Jsalaz1989/Vapo/Arduinos/README.md

Proyecto de la asignatura de Microcontroladores y Lógica Programable del Máster. Es un vaporizador basado en Arduino que calienta un horno mediante control PID según indica el sensor de temperatura. 

Un Arduino Uno se comunica mediante I2C con un Arduino Uno Wifi para intercambiar datos y comandos. El Arduino Uno Wifi se comunica mediante MQTT con una Raspberry Pi, lo cual sirve de base para otro proyecto (asignatura de Computadores y Programación).
