Jsalaz1989/Vapo/Presentación.pptx

Flask

MQTT Bróker

Usuario + Presets

List:
Temp + Sesión

Temp + Sesión

MongoDB

Dict:
Temp + Sesión

Dict:
Temp

List:
Temp

Sub:
On, Temp

Pub:
On, Temp

MQTT Client

Arduino UNO Wifi

Control:
On, Temp

I²C

Reportar:
Temp

Pub:
Temp

Sub:
Temp

MQTT Client

Temp + Sesión

Protobuf

GUI

Arduino UNO

Notes: GENERAL

## Slide 2

https://youtu.be/7sbwrf8wxNI

Flask

MongoDB

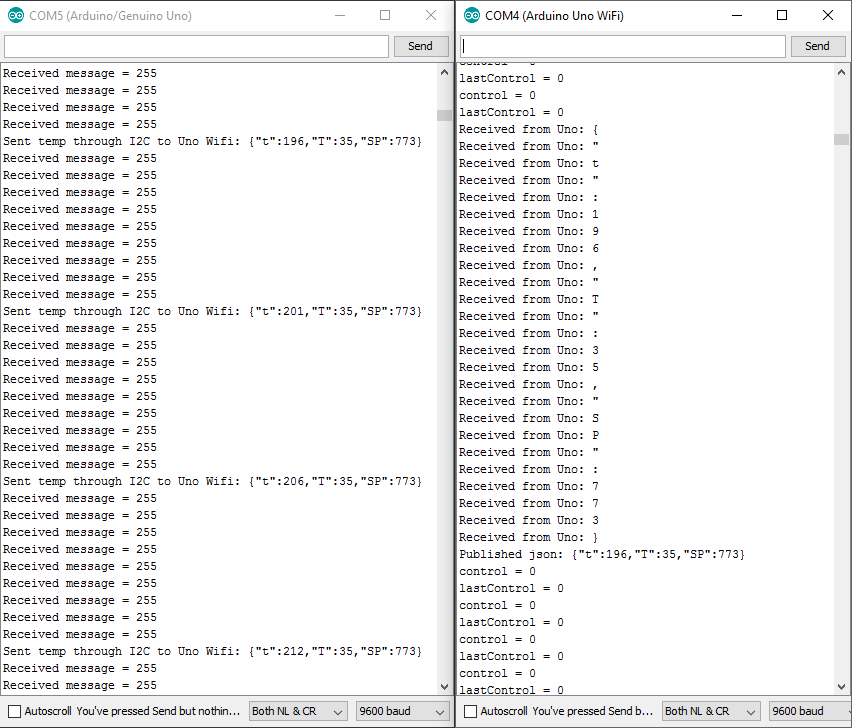
[picture p1: figure]

MQTT Bróker

pubControl(999)

vape/control
pubControl(0)

subTemp()

vape/temp
hilo

List:
Temp + Sesión

Temp + Sesión

Dict:
Temp + Sesión

MQTT Client

Dict:
Temp

List:
Temp

Sub:
On, Temp

Pub:
On, Temp

MQTT Client

Arduino UNO Wifi

Control:
On, Temp

I²C

Reportar:
Temp

Pub:
Temp

Sub:
Temp

Temp + Sesión

Protobuf

Usuario + Presets

GUI

Arduino UNO

Notes: MQTT

## Slide 3

Volver a elección de usuario

Elegir usuario

Historial (mongoDB)

Flask

MongoDB

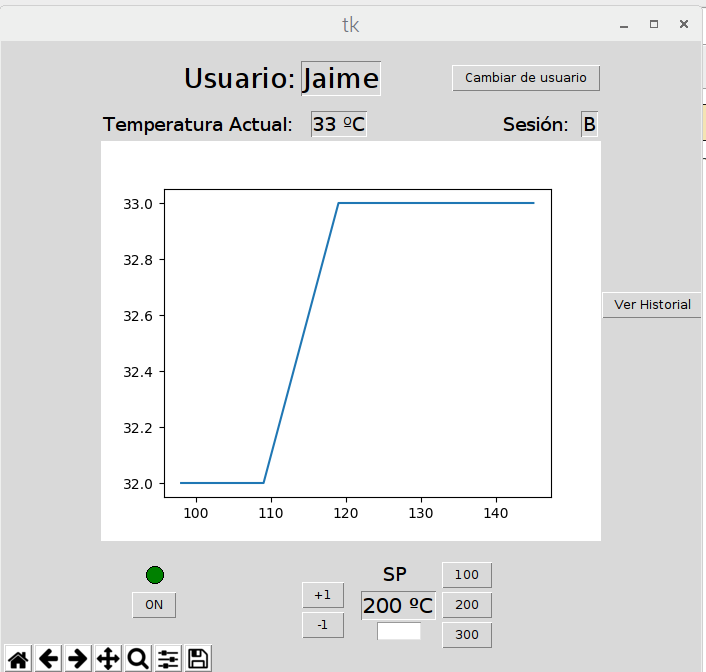
[picture p2: figure]

Borrar mongo al arrancar GUI
y al apagar Arduino

Gráfico (borrar y sobrescribir)

MQTT Bróker

Usuario + Presets

List:
Temp + Sesión

Funciones de actualización

self.after()

subTemp()

pubControl(999)

Temp + Sesión

Dict:
Temp + Sesión

hilos

Dict:
Temp

List:
Temp

Sub:
On, Temp

Pub:
On, Temp

MQTT Client

Arduino UNO Wifi

Control:
On, Temp

I²C

Reportar:
Temp

readPerfil(usuario)

readmessage.py con if

https://youtu.be/6FR_B6w8pXI

Pub:
Temp

Sub:
Temp

MQTT Client

Temp + Sesión

Arduino UNO

Protobuf

GUI

Notes: GUI

## Slide 4

https://youtu.be/6FR_B6w8pXI
(el mismo de la diapositiva anterior)

deleteAllMongo()

Flask

getMongo()

subTemp()

postMongo()

MQTT Bróker

animate()

List:
Temp + Sesión

Temp + Sesión

MongoDB

Dict:
Temp + Sesión

Dict:
Temp

List:
Temp

Sub:
On, Temp

Pub:
On, Temp

MQTT Client

Arduino UNO Wifi

Control:
On, Temp

I²C

Reportar:
Temp

Pub:
Temp

Sub:
Temp

while

GUI

MQTT Client

Temp + Sesión

Arduino UNO

Protobuf

Usuario + Presets

Notes: GRÁFICA (MONGO)

## Slide 5

Flask

https://youtu.be/MhaEAIw5f68

deleteCarriotsSession(sesion)

MQTT Bróker

List:
Temp + Sesión

getCarriots()

subTemp()

postCarriots()

MQTT Client

Temp + Sesión

if “A”
elif “B”

Dict:
Temp + Sesión

en cambio de sesión
if

MongoDB

animate()

Dict:
Temp

List:
Temp

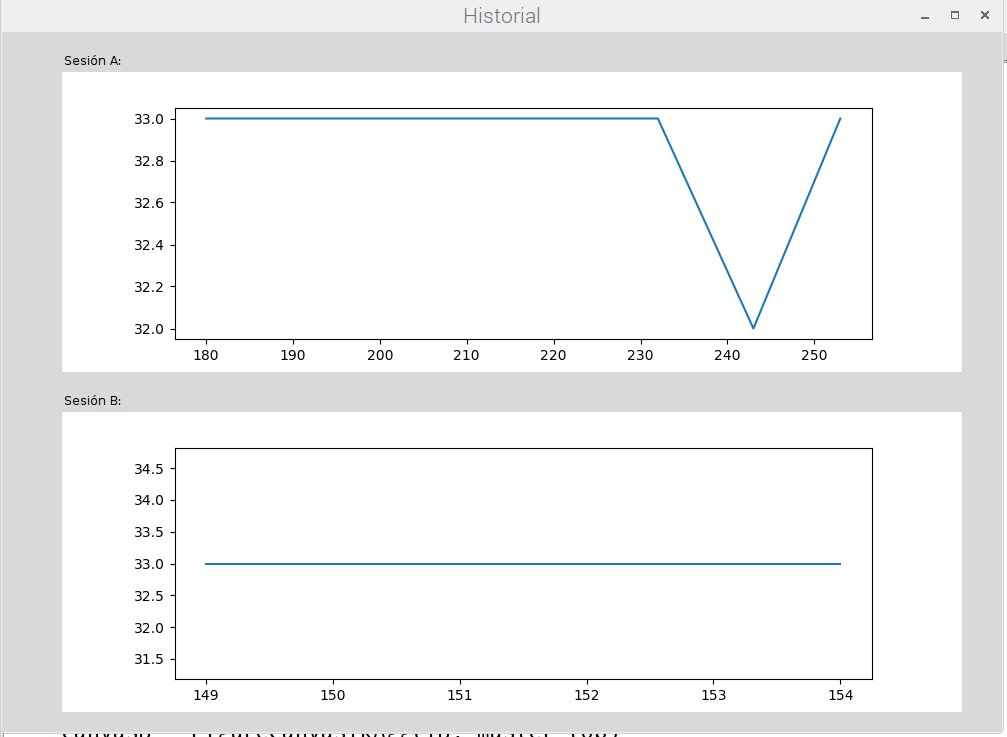
[picture p3: figure]

Sub:
On, Temp

Pub:
On, Temp

MQTT Client

Arduino UNO Wifi

Control:
On, Temp

I²C

Reportar:
Temp

Pub:
Temp

Sub:
Temp

GUI

Temp + Sesión

Arduino UNO

Protobuf

Usuario + Presets

Notes: HISTORIAL (CARRIOTS)

## Slide 6

Flask

@app.route(“/usuario/<sesion>”)
if sesion

getMongo()

MQTT Bróker

List:
Temp + Sesión

Temp + Sesión

MongoDB

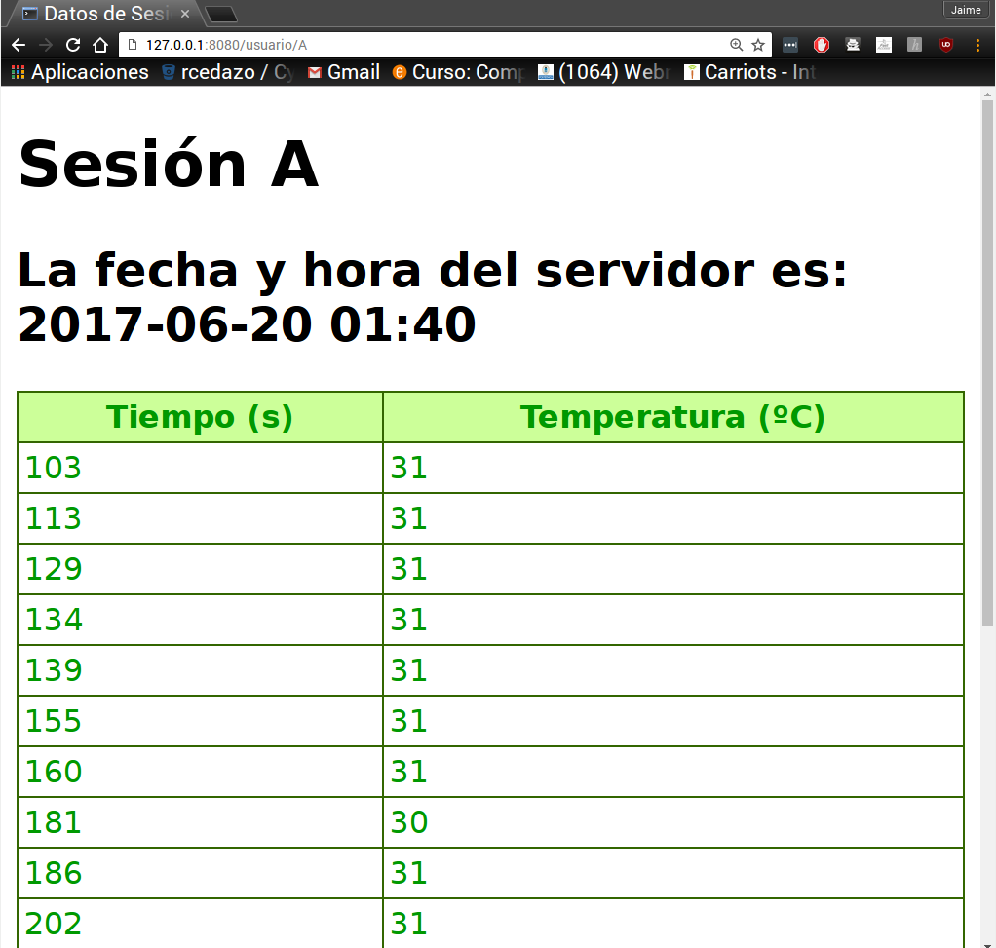
[picture p4: figure]

Dict:
Temp + Sesión

List:
Temp

Dict:
Temp

https://youtu.be/TPxzVgZ_yS8

Sub:
On, Temp

Pub:
On, Temp

MQTT Client

Arduino UNO Wifi

Control:
On, Temp

I²C

Reportar:
Temp

Pub:
Temp

Sub:
Temp

WEB

MQTT Client

Temp + Sesión

Arduino UNO

Protobuf

Usuario + Presets

Notes: HISTORIAL (CARRIOTS)

## Referencias

- https://circuits.io/ (https://www.adafruit.com/includes/templates/adafruit2013/images/little_pi.png)
- https://www.adafruit.com/includes/templates/adafruit2013/images/little_pi.png
- https://cdn.pixabay.com/photo/2016/03/30/13/24/wifi-1290667_960_720.png
- http://www.hotelcentral-basilica.hu/inc/filemanager/files/download.png
- https://www.carriots.com/
