Jsalaz1989/Vapo/Memoria.pdf

# Vaporizador

# Basado en Arduino

## Máster en Ingeniería Electromecánica

### Microcontroladores y Lógica Programable

### Jaime Salazar Lahera junio 2017

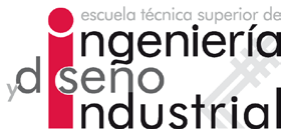
[picture p5: figure]

Microcontroladores y Lógica Programable, Sistemas Mecatrónica Máster en Ingeniería Electromecánica

## Vaporizador Basado en Arduino

### 0 General

Se trata de un vaporizador de muestras vegetales o aceites esenciales que volatiliza el material en un horno pequeño. Consiste principalmente de un Arduino Uno R3, un Arduino Uno Wifi, un horno, y un sensor de temperatura (Figura 0.0, Anexo?).
El Arduino Uno Wifi recibe las señales de los

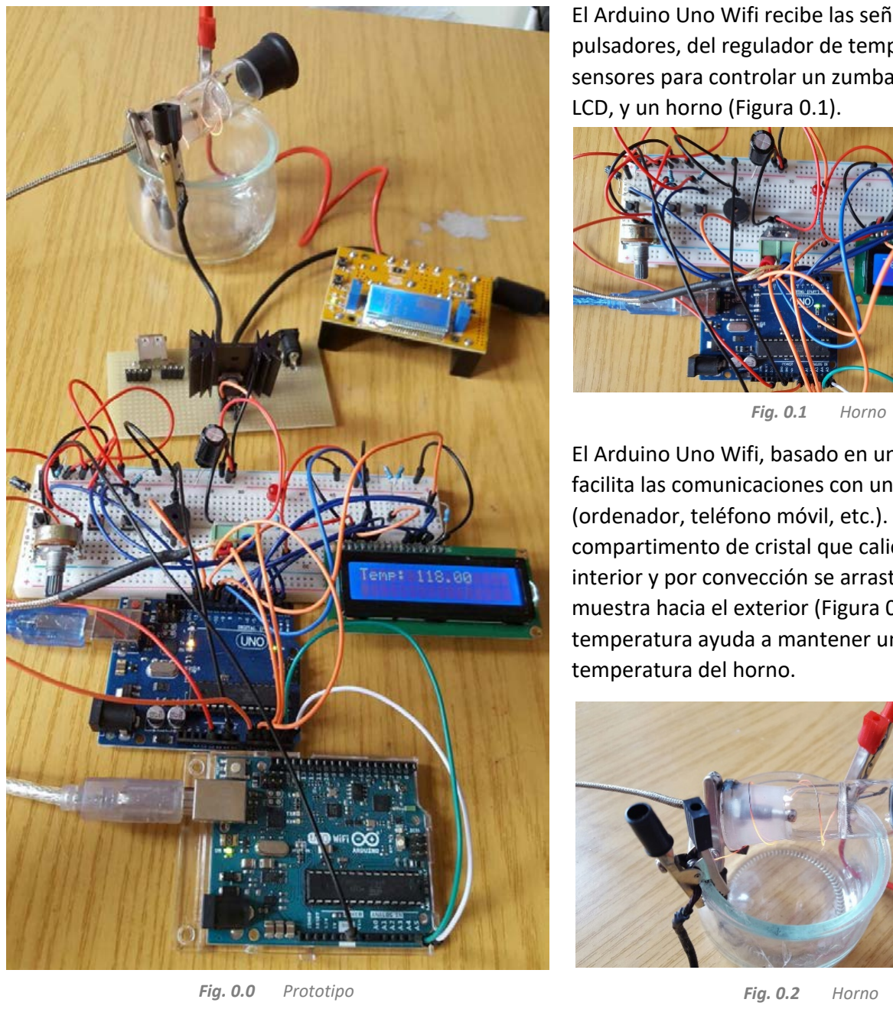
[picture p6: figure]
Fig. 0.0 Prototipo; Fig. 0.2; Horno; Fig. 0.1

pulsadores, del regulador de temperatura, y de los sensores para controlar un zumbador, una pantalla LCD, y un horno (Figura 0.1).

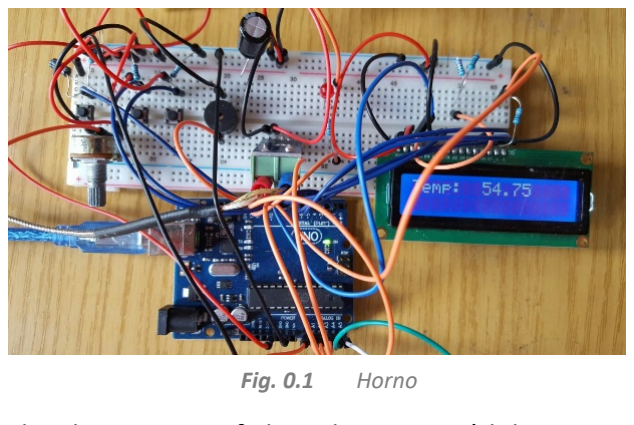
[picture p7: figure]

El Arduino Uno Wifi, basado en un módulo ESP8266, facilita las comunicaciones con una interfaz externa (ordenador, teléfono móvil, etc.). El horno es un compartimento de cristal que calienta el aire en su interior y por convección se arrastra los vapores de la muestra hacia el exterior (Figura 0.1). Un sensor de temperatura ayuda a mantener un seguimiento de la temperatura del horno.

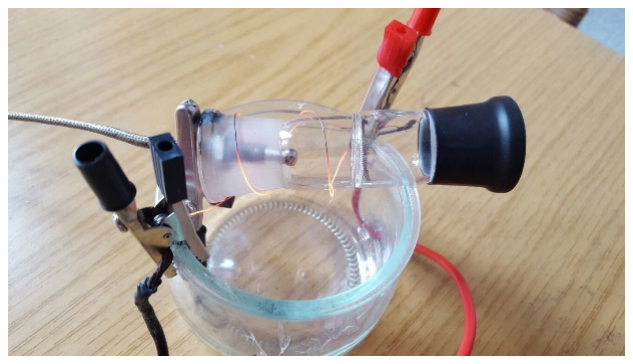
[picture p8: figure]

La Figura 0.3 es un esquema final desarrollado en la página www.circuits.io. Su selección limitada de componentes obliga a representar, por ejemplo, al sensor de temperatura de 5 patillas con sólo 3 o el transistor de forma TO-220 como un pequeño transistor PN2222. No obstante, se presenta como una idea básica del circuito en cuestión.

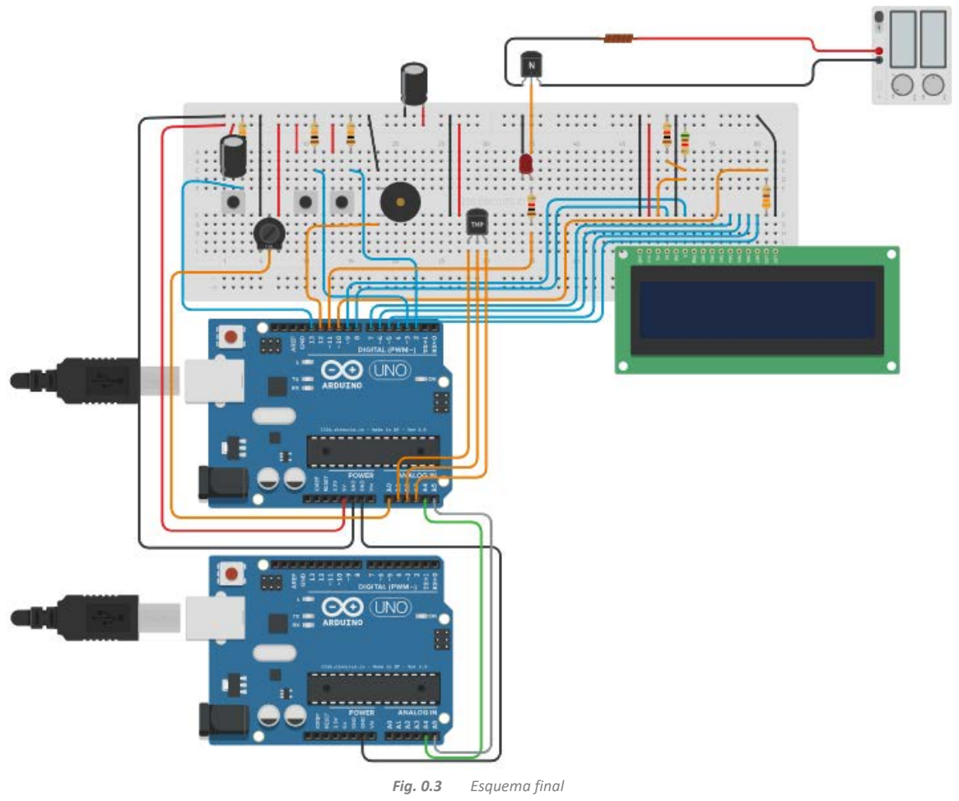
[picture p9: figure]
Fig. 0.3; Esquema final

Las etapas principales del proyecto son las siguientes:

Cada etapa resume primero el circuito y su código final (Descripción), seguido por apuntes complementarios sobre su desarrollo (Proceso), y las fuentes utilizadas (Referencias).

### 1 Pulsador ON

Descripción
El pulsador ON enciende o apaga el vaporizador dependiendo de si el sistema actualmente está apagado o encendido, respectivamente. Con la función attachPinChangeInterrupt() de la librería PinChangeInt.h¹

, (http://playground.arduino.cc/Main/PinChangeInterrupt)
se prepara una interrupción en la patilla digital 11, sin tener que limitarse a las patillas 2 y 3 que se utilizan por defecto para interrupciones externas. De esta forma, se reservan estas dos patillas para los pulsadores de temperatura. La interrupción se lanza con un flanco positivo del pulsador ON mediante su parámetro ´RISING´ y llama a la función onOff(). El rebote se ha eliminado con un condensador electrolítico de 1 μF.
Dentro de onOff() se encuentran on() y off(),
de formato y propósito prácticamente opuestos.
Respectivamente, éstas activan o desactivan al
temporizador de seguridad, emiten un tono alto y corto o bajo y largo mediante tone()³

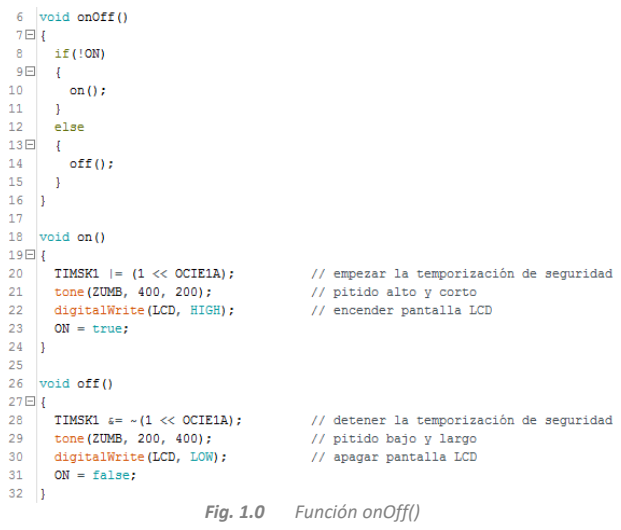
[picture p10: figure]
Fig. 1.0 Función onOff()

, (https://www.arduino.cc/en/reference/tone) encienden
o apagan la pantalla LCD, y establecen el valor de la marca booleana ON (Figura 1.0).
Dentro del loop(), la marca ON habilita al horno, la pantalla LCD, y el envío de datos de temperatura y, además, mediante con millis() se “ralentiza” la frecuencia de ejecución de estas funciones para reducir el gasto energético (Figura 1.1). Se permite recibir el control remoto aún apagado por si llega un commando de encendido.

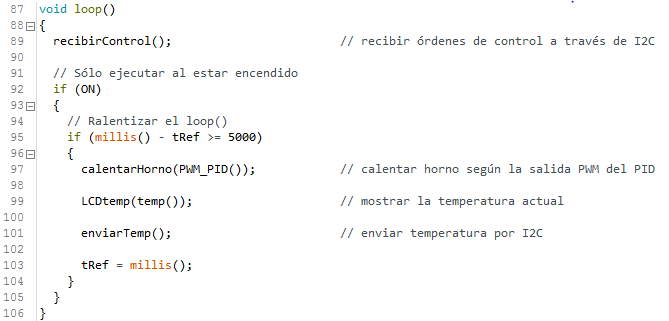
[picture p11: figure]

Fig. 1.1 Función loop()

Como medida de seguridad, nada más encenderse el vaporizador se inicia una temporización de 30 minutos con el temporizador 1, tras los cuales se apaga el sistema. En el setup() la función inicializarISR() inicializa a esta ISR (Figura 1.2) deshabilitando primero a las interrupciones globales y reseteando los registros TCCR1A y TCCR1B. A continuación, se establece una comparación con un valor de 1 segundo, el modo CTC del temporizador, y un pre-escalado de 1024. Finalmente se habilita esta interrupción, así como las interrupciones globales⁴ (http://www.engblaze.com/microcontroller-tutorial-avr-and-arduino-timer-interrupts/) (Figura 1.1). En particular, OCR1A se compara constantemente con TCNT1, que almacena la cuenta actual del temporizador, ambos siendo registros de 16 bits⁵
. (http://www.atmel.com/Images/Atmel-42735-8-bit-AVR-Microcontroller-ATmega328-328P_Datasheet.pdf) El valor de OCR1A = 15624 surge de la siguiente fórmula, donde tt = 1 es el tiempo deseado de 1 segundo y rr = 6,4 ∙ 10−5 segundos es la resolución del temporizador⁴ : (http://www.engblaze.com/microcontroller-tutorial-avr-and-arduino-timer-interrupts/)

# tt = rr ∙ (OOOOOO1AA + 1) ⇒ OOOOOO1AA = tt

# rr − 1 = 1 ssssss 6,4 ∙ 10−5 ssssss − 1 = 15624

Con un TCCR1A completamente reseteado y un TCCR1B cuyo bit WGM12 se pone a 1, se establece la combinación WGM1[3:0] = 0100, codificando el modo 4 de la Tabla 20-6 (modo CTC) con OCR1A como TOP y su actualización inmediata⁵ . (http://www.atmel.com/Images/Atmel-42735-8-bit-AVR-Microcontroller-ATmega328-328P_Datasheet.pdf)
Con un TCCR1B generalmente

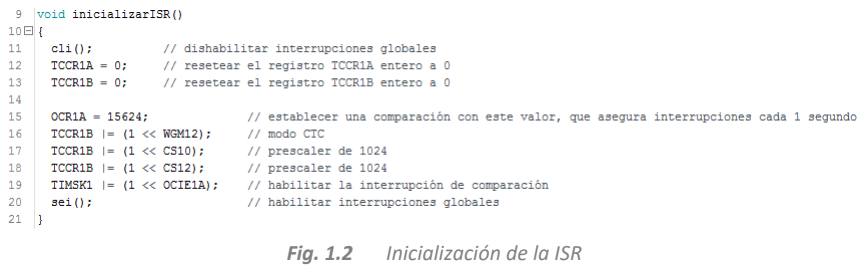
[picture p12: figure]
Fig. 1.2 Inicialización de la ISR

reseteado y una activación de sus bits CS10 y CS12, los tres primeros bits del registro TCCR1B son de la forma de 101, codificando para un pre-escalado de 1024. Finalmente, se habilita esta interrupción de comparación en la máscara TIMSK1 al poner su bit OCIE1A a 1 y se habilitan las interrupciones generales para finalizar la inicialización de la interrupción (Figura 1.2).
Esta inicialización lanza la ISR cada segundo, añadiendo 1 al contador de segundos. Cada 1800 interrupciones (cada 30 minutos) se reinicia la cuenta y se llama a off() para apagar el vaporizador (Figura 1.3), si el usuario se deja el vaporizador encendido, a la media hora se apaga el dispositivo y se evita también el gasto energético.

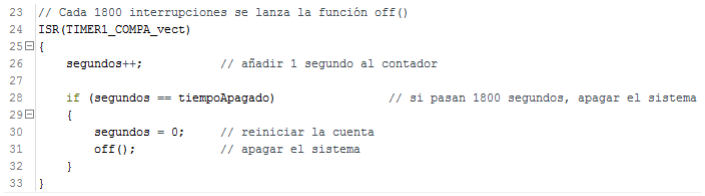
[picture p13: figure]

Fig. 1.3 ISR

Proceso
Para reducir el uso de materiales, es preferible eliminar el rebote por medio del software pero las funciones millis() o delay() no son muy compatibles con las interrupciones⁶

. (https://arduino.stackexchange.com/questions/22212/using-millis-and-micros-inside-an-interrupt-routine)
También era preferible encontrar un valor del registro OCR1A que produjese una interrupción a los 30 minutos, pero el límite de los temporizadores de unos pocos segundos⁷ (https://forum.arduino.cc/index.php?topic=419606.0) ha resultado en el método de interrupciones de un 1 segundo descrito anteriormente. Haciendo pruebas de 10 segundos se observa en la Figura 1.4 que la primera interrupción se lanza a los 2 milisegundos, probablemente el tiempo que transcurre entre el encendido del Arduino, su recorrido por setup(), y los primeros ciclos del loop().

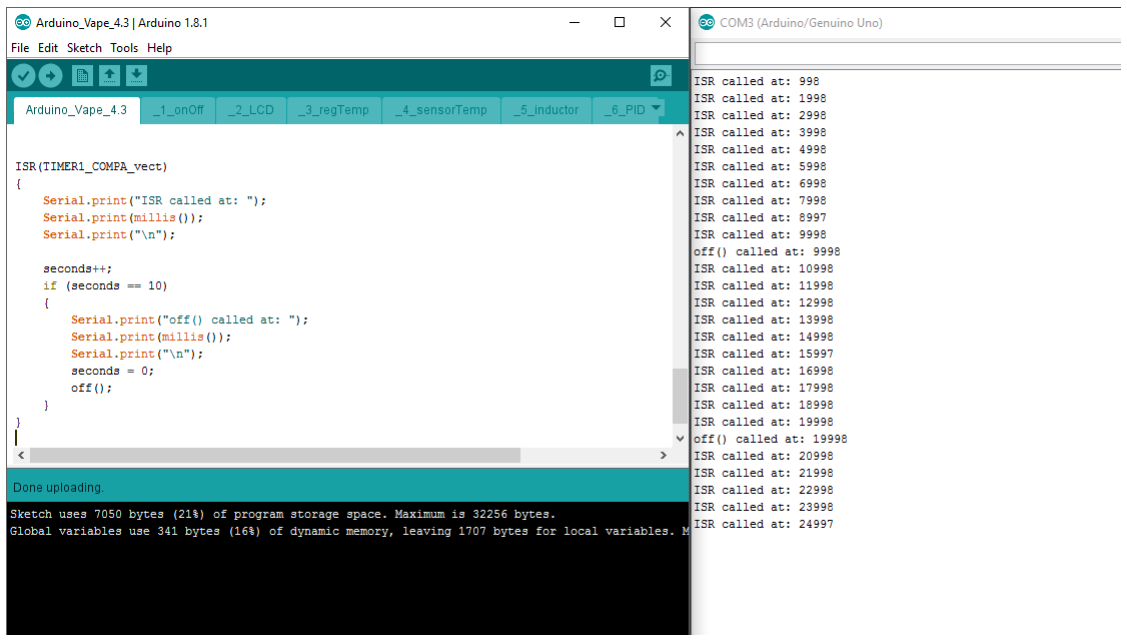
[picture p14: figure]

Ya que el Arduino en principio sigue contando y ejecutando las interrupciones pese a la llamada a off(), conviene desactivar la máscara TIMSK1 en dicha función para reducir cualquier gasto energético asociado a estas interrupciones innecesarias, aunque se trate de un gasto mínimo.

Referencias
1. http://playground.arduino.cc/Main/PinChangeInterrupt
2. https://brainy-bits.com/blogs/tutorials/make-any-arduino-pin-an-interrupt-pin
3. https://www.arduino.cc/en/reference/tone
4. http://www.engblaze.com/microcontroller-tutorial-avr-and-arduino-timer-interrupts/
5. http://www.atmel.com/Images/Atmel-42735-8-bit-AVR-Microcontroller-ATmega328-328P_Datasheet.pdf
6. https://arduino.stackexchange.com/questions/22212/using-millis-and-micros-inside-an-interrupt-routine
7. https://forum.arduino.cc/index.php?topic=419606.0

Fig. 1.4 Prueba del ISR

### 2 Pantalla LCD

Descripción
La pantalla LCD (16x2) se enciende con el pulsador ON ya que éste manda 5 V al ánodo de la pantalla (Sección 1). Inmediatamente en el setup() la función LCDinit() muestra una pantalla de bienvenida (Figura 2.1). En el loop() cada 5 segundos se llama a la función LCDtemp() (Figura 1.1) para que muestre en pantalla el resultado de la función temp() proveniente del sensor de temperatura (Sección 4). De esta forma, se refresca la pantalla al mismo ritmo al que se actualiza la temperatura actual. Por último, la pantalla también muestra el valor de temperatura deseado cada vez que se modifica mediante el regulador de temperatura (Sección 3).

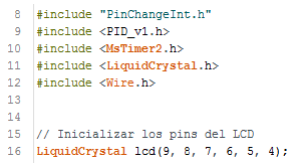
[picture p15: figure]
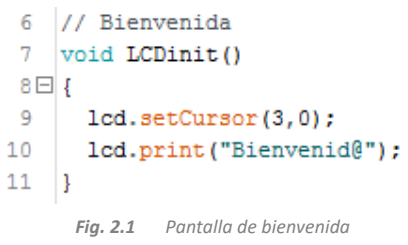
[picture p16: figure]
Fig. 2.1 Pantalla de bienvenida

Con la librería de LiquidCrystal.h se inicializa la pantalla LCD con su 6 patillas (Figura 2.2). En el fichero “_2_LCD.ino” se crea la función LCDtemp(), que recibe el valor de la temperatura actual según el sensor de temperatura y la muestra en pantalla. Varía la posición del valor según su número de dígitos para alinear la coma decimal (Figura 2.3).

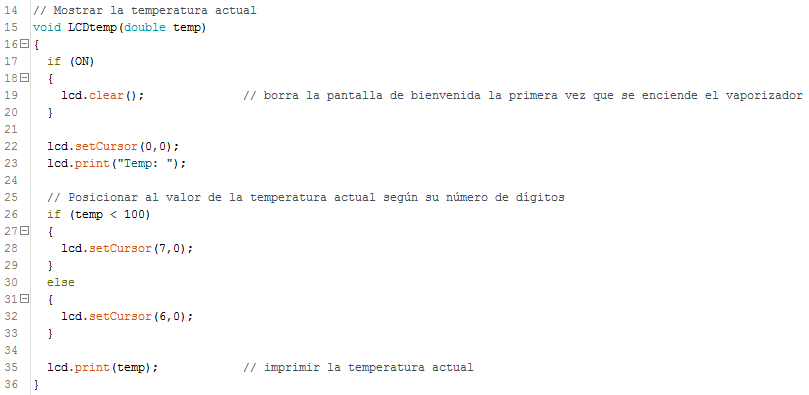
[picture p17: figure]

Fig. 2.3 Temperatura actual en pantalla

Fig. 2.2 Pantalla de bienvenida

Proceso
La luz de fondo de la pantalla se ha establecido con un divisor de tensión para simplificar los materiales, aunque un potenciómetro produce un mejor contraste. Los valores de las resistencias del divisor se basaron en las medidas del divisor formado por el potenciómetro. Al estar las demás patillas ocupadas con los demás componentes, no se ha podido utilizar una patilla PWM para controlar la luz de fondo, aunque sería preferible para reducir aún más el uso de materiales.
El parpadeo de la pantalla de temperatura actual se solucionó con la ralentización del loop(), ya que la función lcd.print() estaba intentando imprimir y re-imprimir a un ritmo excesivo¹

. (http://forum.arduino.cc/index.php?topic=138249.0) Los problemas a la hora de mostrar la consigna se detallan en la siguiente sección ya que están muy ligados a esa interrupción.
Referencias
1. http://forum.arduino.cc/index.php?topic=138249.0

### 3 Regulador de Temperatura

Descripción
Para establecer la temperatura deseada se puede utilizar pulsadores o un potenciómetro. Con los pulsadores se incrementa o decrementa la consigna actual al lanzar las interrupciones externas 0 y 1, asociadas a las patillas 2 y 3, que llaman a las funciones incrementSP() y decrementSP(), respectivamente. Éstas funciones casi idénticas primero deshabilitan al resto de funciones del
sistema mediante el marcador ON. De esta forma, mientras se
esté modificando la consigna ni el horno ni su controlador PID

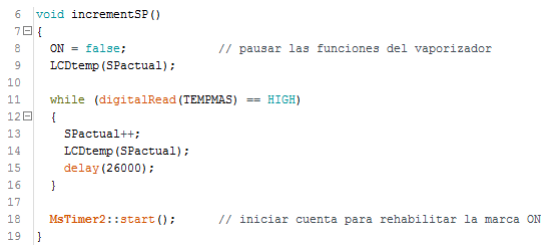
[picture p18: figure]

están activos. La función inmediatamente muestra el valor de la consigna actual y, mientras el usuario siga presionando el pulsador en cuestión, aumenta o disminuye el valor de SPactual, mientras se actualiza el valor de la consigna en pantalla con LCDtemp(SPactual) (Figura 3.0). El bucle while() junto con delay() resulta en un barrido de temperaturas mientras se mantenga presionado al pulsador. El uso de estas funciones dentro de una interrupción se detalla en la siguiente sección (Proceso). Una vez se deja de pulsar el botón empieza una cuenta en el temporizador 2 gracias a la librería de MsTimer2.h¹

. (https://playground.arduino.cc/Main/MsTimer2) Ésta establece una resolución de 1 milisegundo en T2 y permite establecer en el setup() una interrupción cada 800 milisegundos que llame a la función habilitar(). Ahora se puede iniciar la cuenta en otras zonas del código con MsTimer2::start(), que aparece en las funciones del fichero “_3_SP.ino”.
Una vez transcurridos los 800 milisegundos, la función habilitar() (Figura 3.1) re-establece al marcador ON, por lo que se podrá resumir las demás funciones del vaporizador. De esta forma, el horno y su PID vuelven a arrancar cuando ya se ha decidido la nueva consigna. La función emite un zumbido para confirmar el cambio de consigna, borra la pantalla LCD de la consigna y acelera la

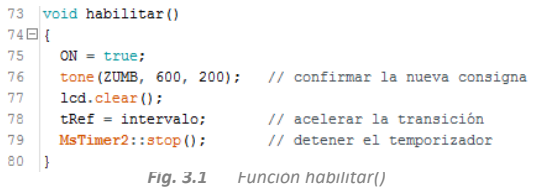
[picture p19: figure]
Fig. 3.1 Función habilitar()

transición de vuelta a pantalla de la temperatura actual. Por último, detiene la temporización.

Fig. 3.0 Incremento de temperatura por pulsador

Por otro lado, se puede variar la consigna con un potenciómetro de 10K, cuyo pin A0 genera una interrupción preparada en el setup() con a la función attachPinChangeInterrupt()que detecta un cambio en el pin del regulador para llamar a la función regTemp() (Figura 3.2). Esta función interpola la lectura analógica del potenciómetro entre 180 y 200 °C con la función map(). En seguida compara lecturas previas y actuales y, con la ayuda de un contador que actúa como temporizador, detecta cuando ha pasado un determinado “tiempo” desde la última vez que se movió el regulador. El uso de while() también se detalla en el siguiente sub-apartado.

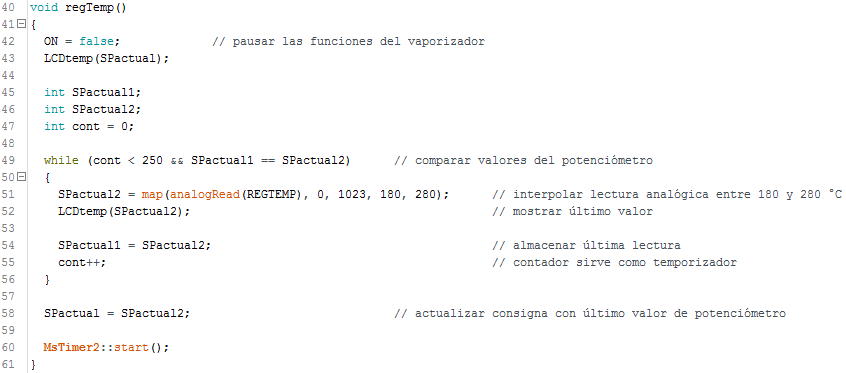
[picture p20: figure]
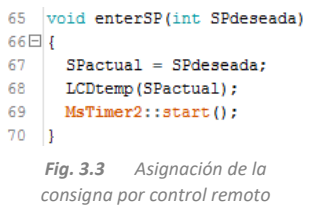
[picture p21: figure]
Fig. 3.3 Asignación de la consigna por control remoto

La última forma de modificar la consigna es mediante la interfaz remota a través de la comunicación I²
C (Sección 7). Para ello se recibe el valor de la consigna como parámetro de la función enterSP(), que actualiza a la variable global SPactual (Figura 3.3).

Proceso
Las interrupciones de los pulsadores aumentan o disminuyen la consigna de uno en uno con cada pulsación. El uso de while() dentro de la interrupción, permite que además, tras un flanco inicial, uno pulso constante produzca un rápido ascenso o descenso de la consigna hasta que se deje de presionar el pulsador. Sin un delay(), este bucle produce ascenso o descenso demasiado rápido y un valor de 2600 como parámetro consigue un barrido de temperaturas a un ritmo satisfactorio. No se ha podido conseguir el mismo efecto con las funciones millis() ni micros(), las cuales no son muy útiles dentro de una interrupción²

. (https://arduino.stackexchange.com/questions/22212/using-millis-and-micros-inside-an-interrupt-routine)
El uso de while() dentro de la interrupción del potenciómetro permite la comparación continua de valores durante suficiente tiempo. De esta forma, el procesador no está constantemente saltando entre el loop() y la interrupción, lo cual en las pruebas iniciales resultaba en saltos erráticos en la consigna al mover el regulador. La Figura 3.4 muestra una prueba inicial de las lecturas analógicas.

Fig. 3.2 Incremento de temperatura por potenciómetro

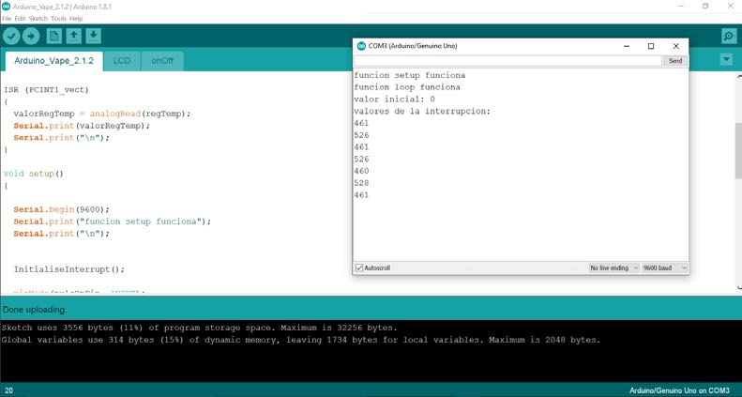
[picture p22: figure]

Los valores de interpolación del potenciómetro son valores de temperatura típicos para vaporizadores herbales y el horno está dimensionado para producir este rango aproximadamente (Sección 5).
En realidad, se preferiría utilizar la interrupción externa 0 para el pulsador ON ya que éste debería tener la máxima prioridad siempre. Sin embargo, por no cruzar cables ni separar a las patillas de los pulsadores TempMás y TempMenos se decidió dejarlo así. No es probable que la jerarquía de interrupciones descrita en la Figura 3.5 tenga mucho efecto en este proyecto ya que un usuario no suele pulsar más de una entrada en un momento dado.

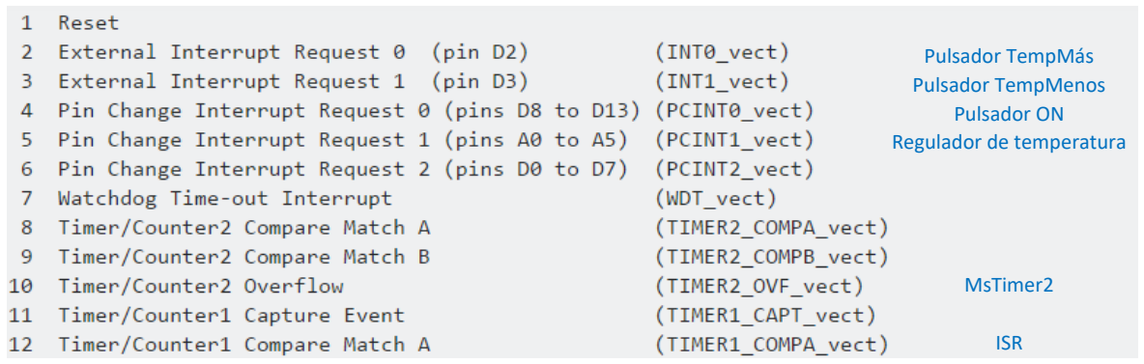
[picture p23: figure]
Pulsador TempMás Pulsador TempMenos Pulsador ON Regulador de temperatura; MsTimer2; ISR

Referencias
1. https://playground.arduino.cc/Main/MsTimer2
2. https://arduino.stackexchange.com/questions/22212/using-millis-and-micros-inside-an-interrupt-routine
3. https://stackoverflow.com/questions/5111393/do-interrupts-interrupt-other-interrupts-on-arduino

Fig. 3.4 Saltos erráticos entre lecturas analógicas

Fig. 3.5 Prioridad de las interrupciones³ (https://stackoverflow.com/questions/5111393/do-interrupts-interrupt-other-interrupts-on-arduino)

### 4 Sensor de Temperatura

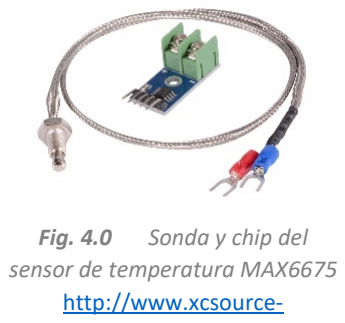
[picture p24: figure]
Fig. 4.0 Sonda y chip del sensor de temperatura MAX6675 http://www.xcsource-

Descripción del Hardware
Un sensor MAX6675 detecta la temperatura del horno cada 5 segundos y, junto con el inductor (Sección 5), permite cerrar el bucle de control PID (Sección 6). Su sonda es capaz de detectar la fuente de calor (entre 0°C y 1023.75°C) con su unión caliente mientras mantiene alejada la unión fría (entre -20°C y 85°C) ¹
, (http://henrysbench.capnfatz.com/wp-content/uploads/2015/05/MAX6675-Datasheet.pdf) es decir, el chip MAX6675 (Figura 4.0). Este chip está conectado a las patillas analógicas del Arduino, aunque normalmente se conectan a las digitales (Figura 4.1). Los termopares de tipo K, como este sensor, trabajan bien en atmósferas oxidantes²
, (https://en.wikipedia.org/wiki/Thermocouple#Type_K) una característica muy conveniente para un sensor de flujos de aire caliente.

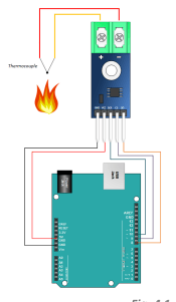
[picture p25: figure]
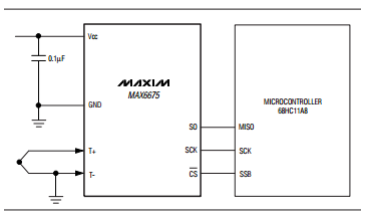
[picture p26: figure]

Al tratarse de un termopar de tipo K, tiene una entrada T- de alumel (niquel-aluminio) y T+ de cromel (niquel-cromo). La Figura 4.2 también muestras su patilla de alimentación (Vcc), de tierra (GND), una salida Serial Data Ouput (SO), y las entradas Serial Clock Input (SCK) y Chip Select (CS)¹
. (http://henrysbench.capnfatz.com/wp-content/uploads/2015/05/MAX6675-Datasheet.pdf)

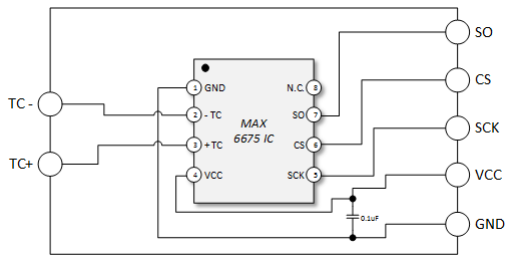
[picture p27: figure]
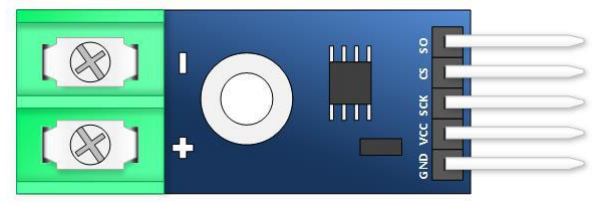
[picture p28: figure]

Fig. 4.2 Detalle de las patillas del sensor³ (http://henrysbench.capnfatz.com/henrys-bench/arduino-temperature-measurements/max6675-temp-module-arduino-manual-and-tutorial/)

Fig. 4.1 Imagen⁴

, (http://henrysbench.capnfatz.com/henrys-bench/arduino-temperature-measurements/max6675-temp-module-arduino-manual-and-tutorial/) cableado⁴

, (http://henrysbench.capnfatz.com/henrys-bench/arduino-temperature-measurements/max6675-temp-module-arduino-manual-and-tutorial/) y diagrama¹ (http://henrysbench.capnfatz.com/wp-content/uploads/2015/05/MAX6675-Datasheet.pdf) del sensor de temperatura Nota: En este proyecto, se usan patillas analógicas en lugar de digitales

La Figura 4.14 contiene al circuito entero del chip MAX6675, el cual se alimenta mediante la fuente VCC, cuyo ruido se recomienda minimizar mediante un condensador cerámico de 0.1 µF¹ (http://henrysbench.capnfatz.com/wp-content/uploads/2015/05/MAX6675-Datasheet.pdf) (Figura 4.4). Éste se coloca cerca del pin de alimentación (Figura 4.4), como es típico de los condensadores de paso, también conocidos como de derivación (Figura 4.4)
5

. (http://www.electronica2000.com/temas/capacitores-de-paso.htm)

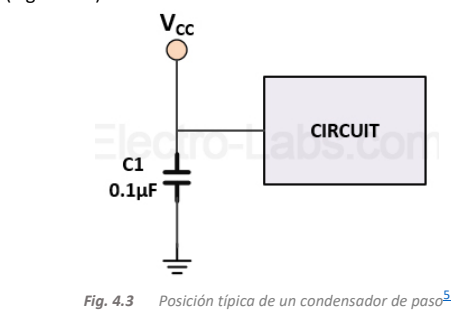
[picture p29: figure]
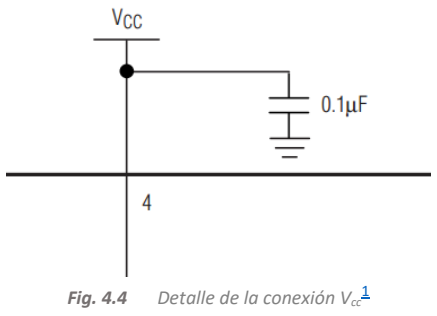
[picture p30: figure]
Fig. 4.4 Detalle de la conexión Vcc1

Este tipo de condensador limpia la señal de entrada, una tensión c.c. con pequeñas oscilaciones c.a., para producir una tensión c.c. pura (Figura 4.5 y 4.6).

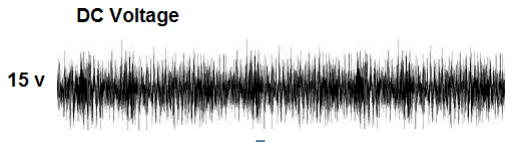
[picture p31: figure]
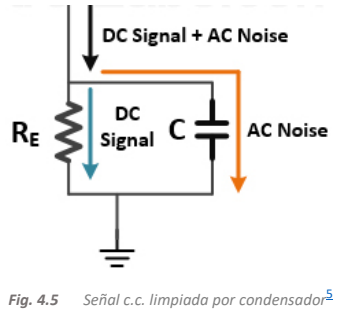
[picture p32: figure]

Esta tensión alimenta al amplificador A1, descrito en el manual como un amplificador de bajo ruido (LNA)¹

, (http://henrysbench.capnfatz.com/wp-content/uploads/2015/05/MAX6675-Datasheet.pdf) que
recibe las señales del termopar T+ y T- (Figura 4.7). Estas entradas pasan primero por los conmutadores S1, S2, y S3, que no se detallan en la documentación oficial, pero podrían tratarse de interruptores chopper que trocean la señal continua para producir una señal alterna, que es más fácil de manejar dentro de un amplificador⁷
. (https://en.wikipedia.org/wiki/Chopper_(electronics)#Chopper_amplifiers) Aunque el
diagrama representa a este amplificador como un amplificador operacional (op-amp) estándar, casi siempre se trata de 3 op-amps (Figura 4.8) que forman un amplificador de instrumentación⁷
. (https://en.wikipedia.org/wiki/Instrumentation_amplifier)

Fig. 4.6 Limpieza de una señal c.c.⁶ (http://www.learningaboutelectronics.com/Articles/What-is-a-bypass-capacitor.html) Fig. 4.5 Señal c.c. limpiada por condensador⁵ (http://www.electronica2000.com/temas/capacitores-de-paso.htm)

Fig. 4.3 Posición típica de un condensador de paso⁵ (http://www.electronica2000.com/temas/capacitores-de-paso.htm)

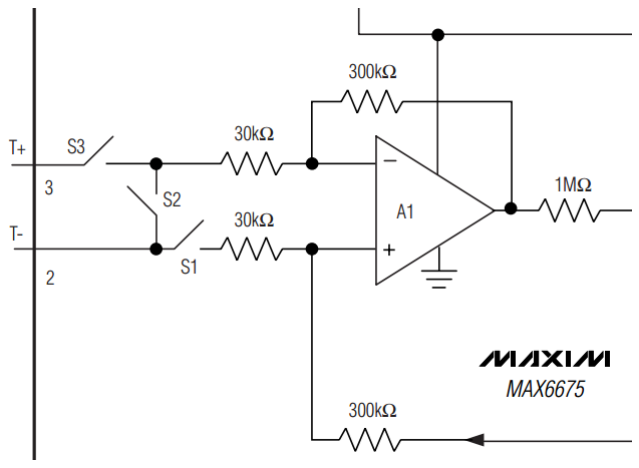
[picture p33: figure]

Fig. 4.7 Detalle del amplificador A1¹ (http://henrysbench.capnfatz.com/wp-content/uploads/2015/05/MAX6675-Datasheet.pdf)

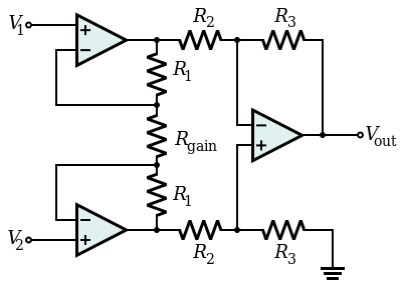
[picture p34: figure]

Fig. 4.8 Amplificador de instrumentación⁸ (https://en.wikipedia.org/wiki/Instrumentation_amplifier)

Los dos primeros op-amps funcionan como buffers para cada entrada (+,-) y proporcionan una tensión entre las dos entradas (justo antes de las resistencias 2 = 30 kkkk) de: VViiiiiiiiiiiiiiiiiiii = (VV2 − VV1) 1 + 2RR1

# RRgggggggg9

. (https://es.wikipedia.org/wiki/Amplificador_de_instrumentaci%C3%B3n) Como no se
conocen los valores de las resistencias 1 ni gg , no se puede calcular la ganancia de esta etapa, pero se sabe que los amplificadores de instrumentación suelen ser amplificadores diferenciales con un alto factor rechazo al modo común y una pequeña ganancia de modo común
RR2
RR3

# = 30 kkkk

300 kkkk = 0.1. Es decir, la primera etapa del

amplificador A1 es muy capaz de rechazar el ruido ambiental común a las dos entradas sin amplificarlo mucho¹⁰. (https://en.wikipedia.org/wiki/Common-mode_rejection_ratio) En la segunda etapa, la tensión intermedia caerá por igual al cruzar las resistencias 2, por lo que llegará la misma diferencia a las entradas del tercer op-amp. Éste producirá una tensión de salida VVoo = (VV2 − VV1) 1 + 2RR1

# RRgggggggg RR3

RR2

# 9 (https://es.wikipedia.org/wiki/Amplificador_de_instrumentaci%C3%B3n)

con una ganancia de RR3
RR2

# = 300 kkkk

30 kkkk = 10. Finalmente, para evitar el bias del amplificador, se introduce en su entrada

no inversora una tensión de referencia (Figura 4.9). Con esto se corrige el hecho de que, para una tensión diferencial de 0 V en su entrada, algo de tensión estaba apareciendo a su salida¹¹. (https://ocw.mit.edu/courses/media-arts-and-sciences/mas-836-sensor-technologies-for-interactive-environments-spring-2011/readings/MITMAS_836S11_read02_bias.pdf) En resumen, al situar al LNA A1 cerca de la fuente de la señal, su ganancia general amplifica la señal y la hace más robusta frente al ruido que se pueda originar en las siguientes etapas del circuito¹². (https://en.wikipedia.org/wiki/Low-noise_amplifier#Noise_reduction)
Antes de llevar la salida de A1 al convertidor analógico-digital, conviene pasarla por un filtro de paso bajo RC para reducir el ruido fuera del ancho de banda deseado¹³ (http://www.analog.com/en/analog-dialogue/articles/common-problems-when-designing-amplifier-circuits.html) (Figura 4.10). Según el teorema de muestreo de Nyquist, la máxima frecuencia contenida en la señal de entrada debe ser menor o igual a la mitad de la frecuencia de muestreo¹⁴. (http://digital.ni.com/public.nsf/allkb/68F14E8E26B3D101862569350069E0B9) Al permitir sólo el paso de bajas frecuencias, este filtro anti-alias se asegura de que las frecuencias por

encima de ffcc = 1

# 2ππ ππ = 1

2ππ(1 MM )(20 pppp) = 7957.75 HHHH (ruido) no se van a muestrear¹⁴ (http://digital.ni.com/public.nsf/allkb/68F14E8E26B3D101862569350069E0B9) (Figura 4.10). Esta señal

filtrada se pasa por el op-amp seguidor de tensión A2 (Figura 4.10), que proporciona esta misma tensión en su salida. Gracias a su alta impedancia de entrada y baja impedancia de salida, sirve como buffer que aísla al termopar del chip y permite medir la tensión del termopar utilizando una intensidad muy pequeña que no afecte a la medición del sensor¹⁵. (https://es.wikipedia.org/wiki/Amplificador_operacional#Seguidor_de_voltaje_o_tensi.C3.B3n)

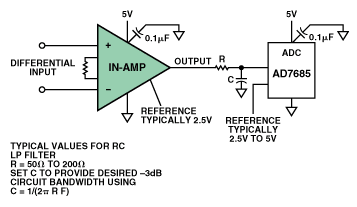
[picture p35: figure]

Fig. 4.9 Filtro anti-aliasing¹³ (http://www.analog.com/en/analog-dialogue/articles/common-problems-when-designing-amplifier-circuits.html)

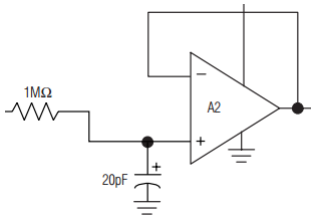
[picture p36: figure]

Fig. 4.10 Detalle del amplificador A2¹ (http://henrysbench.capnfatz.com/wp-content/uploads/2015/05/MAX6675-Datasheet.pdf)

Como los termopares producen una diferencia de tensión debido al efecto Seebeck (el in-amp A1 es esencialmente un amplificador diferencial), esta diferencia se debe sumar a una referencia para producir el valor absoluto de tensión¹⁶ (https://es.wikipedia.org/wiki/Compensaci%C3%B3n_de_uni%C3%B3n_fr%C3%ADa) (Figura 4.11). Con esta compensación por unión fría, el termopar puede mantener una buena precisión en su unión caliente, aunque fluctúe la temperatura en su unión fría¹ (http://henrysbench.capnfatz.com/wp-content/uploads/2015/05/MAX6675-Datasheet.pdf) (Figura 4.12). El diodo de compensación convierte la lectura de la temperatura ambiental en un voltaje, el cual se suma a la salida de A2¹ (http://henrysbench.capnfatz.com/wp-content/uploads/2015/05/MAX6675-Datasheet.pdf) antes de entrar en el convertidor analógico-digital (ADC en la Figura 4.13). Al tratarse de un termopar de tipo K, la tensión varía 41 µV/°C¹⁷, (https://es.wikipedia.org/wiki/Termopar#Tipos) por lo que se aproxima su ecuación característica a la ecuación lineal VVOOOOOO =
41 µV

# °C ∙ (TR − TA A)1

. (http://henrysbench.capnfatz.com/wp-content/uploads/2015/05/MAX6675-Datasheet.pdf) Finalmente, en el ADC se suma sus dos entradas y manda el resultado de 12 bits a la patilla SO¹
, (http://henrysbench.capnfatz.com/wp-content/uploads/2015/05/MAX6675-Datasheet.pdf) donde 000000000000 = 0°C y 111111111111 = 1023.75 °C.

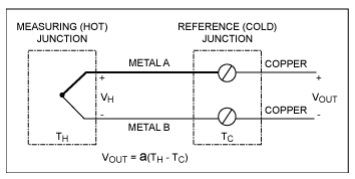
[picture p37: figure]

Fig. 4.12 Unión caliente y fría

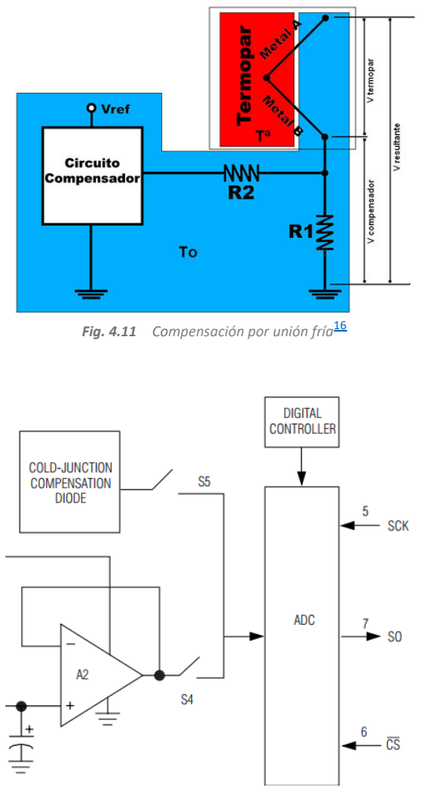
[picture p38: figure]
Fig. 4.11 Compensación por unión fría¹⁶

Fig. 4.13 Tensión relativa + referencia

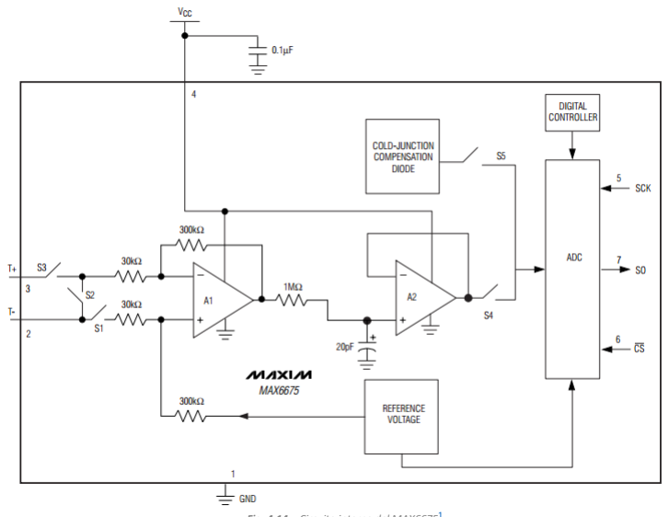
[picture p39: figure]

El chip envía la señal de SO al Arduino a través de la interfaz serie. La comunicación SPI se habilita al deshabilitar la patilla CS y, al aplicar una señal de reloj en la patilla SCK, se lee el resultado en SO. La palabra SO contiene 16 bits (Figura 4.15).

Por lo tanto, se requiere 16 ciclos del reloj para una lectura completa¹

. (http://henrysbench.capnfatz.com/wp-content/uploads/2015/05/MAX6675-Datasheet.pdf) Con el flanco negativo de CS, la conversión en el ADC se detiene inmediatamente y se empieza a escribir los bits D15 – D0 (Figura 4.16). El primer bit no tiene significado y se pone siempre a 0. Los bits D14 a D3 contienen los 12 bits que codifican el valor de la temperatura. El bit D2 normalmente está a 0 y sólo se pone a 1 si se está utilizando el termopar en configuración abierta (con T-a tierra), el cual no es el caso aquí. El bit D1 proporciona un identificador del dispositivo y el DO es un tri-estado¹ , (http://henrysbench.capnfatz.com/wp-content/uploads/2015/05/MAX6675-Datasheet.pdf)
útil a la hora de conectar varios dispositivos mediante la interfaz serie¹⁸. (https://www.cs.umd.edu/class/sum2003/cmsc311/Notes/CompOrg/tristate.html)

Fig. 4.14 Circuito interno del MAX6675¹ (http://henrysbench.capnfatz.com/wp-content/uploads/2015/05/MAX6675-Datasheet.pdf)

Fig. 4.15 Bits del registro SO¹ (http://henrysbench.capnfatz.com/wp-content/uploads/2015/05/MAX6675-Datasheet.pdf)

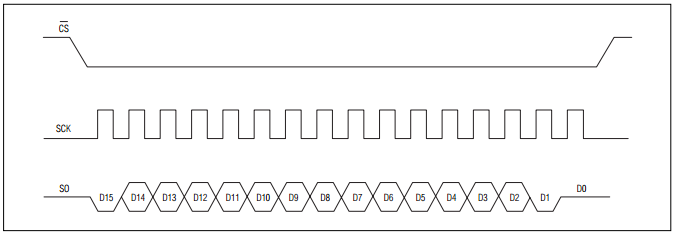
[picture p40: figure]

Descripción del Software
Para este sensor hace falta la librería max6675.h¹⁹ (https://github.com/adafruit/MAX6675-library) que nos permite crear el objeto termopar y asociarle 3 patillas digitales. Por razones de disponibilidad, se ha optado por usar las patillas analógicos A1, A2, y
A3 como si fueran las digitales 15, 16, y 17, respectivamente²⁰, (https://www.arduino.cc/en/Tutorial/AnalogInputPins) 21 (https://forum.arduino.cc/index.php?topic=28720.0) (Figura
4.15).

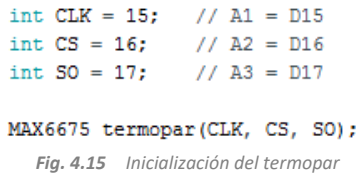
[picture p41: figure]
Fig. 4.15 Inicialización del termopar

La Figura 4.16 muestra la función temp(), que comprueba que no se ha excedido la temperatura de seguridad de 280 °C, en cuyo caso establece un intervalo de muestreo de 3 segundos con millis(), para utilizar la función readCelsius() de la librería del chip⁴

. En caso contrario, se llama a la función off() para apagar el sistema.

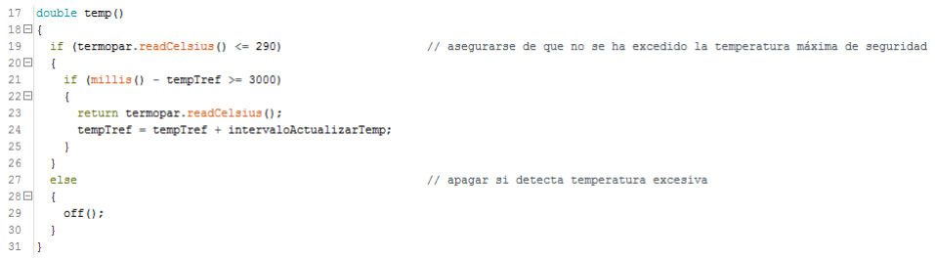
[picture p42: figure]

Un análisis aproximado del reloj serie de 4,3 MHz (Figura 4.18) indica que, para una lectura completa de temperatura (16 ciclos de SO), se puede escribir 268.750 escrituras completas de SO:

# 4,3 ∙ 106 cccccccccc dd rr rr

ssssss

# 16 cccccccccc dd rr rr ee ee cccccccccc dd SS

# = 268.750 ee eess cccccccccc dd SS

ssssss

Fig. 4.16 Función de lectura de temperatura

Fig. 4.16 Escritura del registro SO¹ (http://henrysbench.capnfatz.com/wp-content/uploads/2015/05/MAX6675-Datasheet.pdf)

O bien, cada escritura tarda aproximadamente 3,72 microsegundos:

# 268.750 ee ee cccccccccc dd SS ssssss

−1

# = 3,72 ∙ 10−6 ssssss ee ee cccccccccc dd SS

Para confirmar, de la Figura 4.18 se calcula que cada ciclo de SCK tarda tt CC + tt CC = 100 nn + 100 nn = 2 ∙
10−7 segundos por ciclo de SCK, por lo que los 16 ciclos del SO duran 3,2 x 10⁻⁶ segundos, muy similar al valor

calculado anteriormente. La diferencia entre estos dos valores puede deberse a que se ha elegido los valores mínimos de la Tabla 4 para la subida y bajada de SCK, y se ha ignorado el tiempo entre la caída de CS y la subida de SCK (tCSS), la caída de CS y la habilitación de SO (tDV), la subida de CS y la deshabilitación de SO (tTR), y la caída de SCK y la validación de SO (tDO). De todas formas, la rapidez de este sensor es más que suficiente para el intervalo de muestreo de 3 segundos.

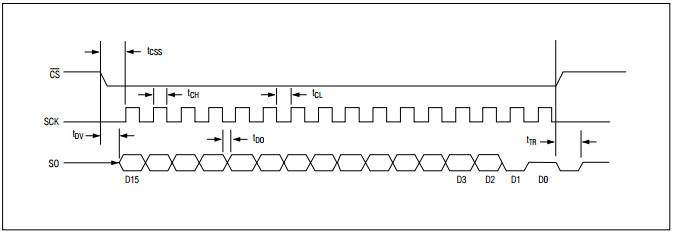
[picture p43: figure]
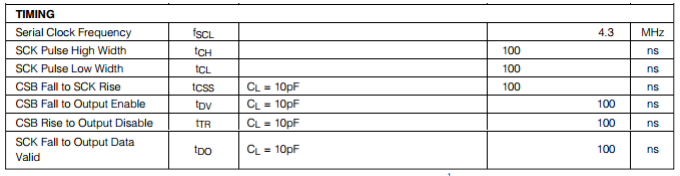
[picture p44: figure]

Proceso
Para los colores de los terminales, una fuente inicial parece asumir que sólo existe el código ANSI y que los fabricantes a veces se equivocan³
. (http://henrysbench.capnfatz.com/henrys-bench/arduino-temperature-measurements/max6675-temp-module-arduino-manual-and-tutorial/) En realidad, parece que hay distintos códigos estandarizados (Figura 4.19) y, en particular, el termopar de este proyecto sigue el estándar BS.

Fig. 4.17 Temporización de escritura del registro SO¹ (http://henrysbench.capnfatz.com/wp-content/uploads/2015/05/MAX6675-Datasheet.pdf)

Fig. 4.18 Tiempos de las patillas CS, SCK, y SO¹ (http://henrysbench.capnfatz.com/wp-content/uploads/2015/05/MAX6675-Datasheet.pdf)

Referencias
1. http://henrysbench.capnfatz.com/wp-content/uploads/2015/05/MAX6675-Datasheet.pdf
2. https://en.wikipedia.org/wiki/Thermocouple#Type_K
3. http://www.xcsource-pic.com/TE578-E-10-main1.jpg
4. http://henrysbench.capnfatz.com/henrys-bench/arduino-temperature-measurements/max6675-temp-module-arduino-manual-and-tutorial/ (http://henrysbench.capnfatz.com/henrys-bench/arduino-temperature-measurements/max6675-temp-module-arduino-manual-and-tutorial/)
5. http://www.electronica2000.com/temas/capacitores-de-paso.htm
6. http://www.learningaboutelectronics.com/Articles/What-is-a-bypass-capacitor.html
7. https://en.wikipedia.org/wiki/Chopper_(electronics)#Chopper_amplifiers
8. https://en.wikipedia.org/wiki/Instrumentation_amplifier
9. https://es.wikipedia.org/wiki/Amplificador_de_instrumentaci%C3%B3n
10. https://en.wikipedia.org/wiki/Common-mode_rejection_ratio
11. https://ocw.mit.edu/courses/media-arts-and-sciences/mas-836-sensor-technologies-for-interactive-environments-spring-2011/readings/MITMAS_836S11_read02_bias.pdf (https://ocw.mit.edu/courses/media-arts-and-sciences/mas-836-sensor-technologies-for-interactive-environments-spring-2011/readings/MITMAS_836S11_read02_bias.pdf)
12. https://en.wikipedia.org/wiki/Low-noise_amplifier#Noise_reduction
13. http://www.analog.com/en/analog-dialogue/articles/common-problems-when-designing-amplifier-circuits.html (http://www.analog.com/en/analog-dialogue/articles/common-problems-when-designing-amplifier-circuits.html)
14. http://digital.ni.com/public.nsf/allkb/68F14E8E26B3D101862569350069E0B9
15. https://es.wikipedia.org/wiki/Amplificador_operacional#Seguidor_de_voltaje_o_tensi.C3.B3n
16. https://es.wikipedia.org/wiki/Compensaci%C3%B3n_de_uni%C3%B3n_fr%C3%ADa
17. https://es.wikipedia.org/wiki/Termopar#Tipos
18. https://www.cs.umd.edu/class/sum2003/cmsc311/Notes/CompOrg/tristate.html
19. https://github.com/adafruit/MAX6675-library
20. https://www.arduino.cc/en/Tutorial/AnalogInputPins
21. https://forum.arduino.cc/index.php?topic=28720.0

### 5 Horno

Descripción
El horno consiste de un hilo de nicromo de aproximadamente 20 cm enrollado sobre un tubo de cristal (la carcasa del hornillo) que calienta el aire en su interior. El hilo se alimenta con una tensión continua de 13,0 V y puede consumir hasta 6,3 A. En todo momento, la corriente que atraviesa a la bobina se controla mediante un transistor Darlington, que recibe en su base la señal PWM de un pin digital del Arduino (Figura 5.0).

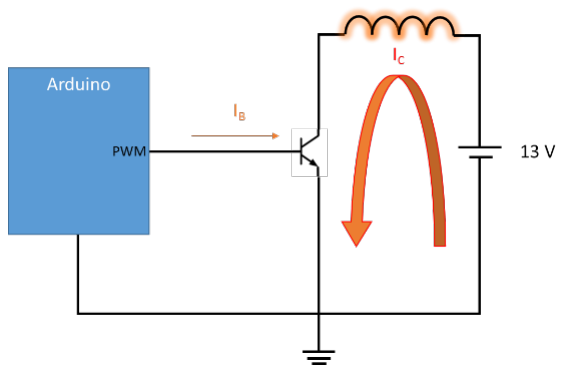
[picture p45: figure]

Fig. 5.0 Control PWM del horno

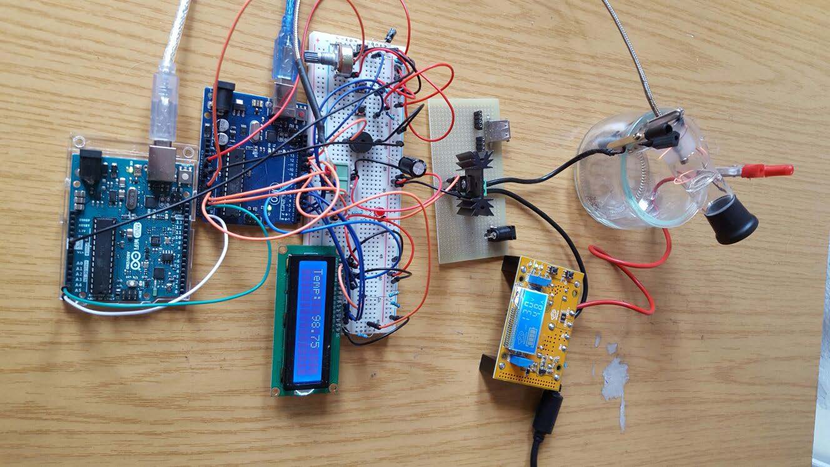
[picture p46: figure]

El hilo de nicromo, una aleación de proporciones variables de niquel-cromo o niquel-cromo-hierro, actúa como una resistencia altamente capaz de disipar la potencia que le atraviesa. Con una resistividad de aproximadamente

ρρ = 1,3 ∙ 10−6 1
, (http://hypertextbook.com/facts/2007/HarveyKwan.shtml) una longitud de LL = 0,2 , y un diámetro de 4,06 ∙ 10−4 , este hilo supone una resistencia

de:
= ρρ

LL
AA = (1,3 ∙ 10−6 )

0,2
ππ

4,06 ∙ 10−4
2

2 ≅ 2

Se pueden encontrar valores similares en otras fuentes, pero al no conocerse las proporciones exactas de esta aleación, el valor real puede diferir un poco del calculado²
. (https://en.wikipedia.org/wiki/Nichrome) Al conducir un máximo de 6,3 A, este hilo disipa una potencia de aproximadamente PP = II2 = (2 ) ∙ (6,3 AA)2 = 79,38 WW, protegiendo al transistor conectado aguas

abajo (Figura 5.0).
Este transistor se trata de un Darlington, es decir, de dos transistores bipolares
NPN integrados (Figura 5.2) en un encapsulado TO-220. Este modelo BDX33C puede soportar una tensión VCB y VCE de al menos 100 V, una corriente en su colector de hasta 10 A, y una corriente en su base de hasta 250 mA³
. (http://www.braude.ac.il/files/departments/electrical_electronic_engineering/labs/data_pages/p5.pdf) No se supera
ninguno de estos límites en esta aplicación, aunque sí se requiere una resistencia de base = 330 y un disipador de calor considerable, no pudiendo superarse

una temperatura en su unión de 150 °C y una disipación en su colector de 70 W³
| . (http://www.braude.ac.il/files/departments/electrical_electronic_engineering/labs/data_pages/p5.pdf)
El transistor se opera en su región activa, amplificando la corriente que le llega desde el Arduino a su base de forma que circula una corriente mucho mayor (β =
250) en su colector, esto es, a través de la bobina.

Fig. 5.1 Maqueta con horno encendido

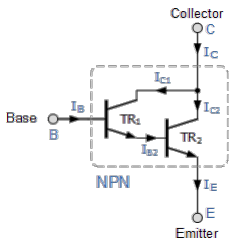
[picture p47: figure]

Fig. 5.2 Transistor Darlington⁴ (http://www.electronics-tutorials.ws/transistor/darlington-transistor.html)

La función calentarHorno() dentro del loop() se encarga de escribir un valor PWM en la patilla digital del transistor. Este valor es la salida de la función PID (Sección 6), que se pasa como un parámetro a calentarHorno() (Figura 5.3). De esta forma, se puede controlar desde el Arduino a la corriente que pasa por la bobina, es decir, a la temperatura del hornillo.

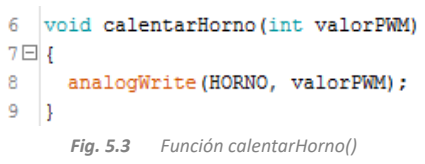
[picture p48: figure]
Fig. 5.3 Función calentarHorno()

Proceso
Para la bobina del horno existen distintas opciones, como módulos prefabricados⁵ (http://alexnld.com/product/5v-12v-zvs-induction-heating-power-supply-module-with-coil/) o escaleras de resistencias⁵

, (http://www.alanzucconi.com/2016/08/02/arduino-heater-1/)
aunque su capacidad de soportar la suficiente corriente para llegar a 200 – 300 °C es dudosa, recomendándose en su lugar el hilo de nicromo⁶, (http://www.alanzucconi.com/2016/08/02/arduino-heater-1/) 7
. (https://www.reddit.com/r/arduino/comments/3s08uf/most_efficient_way_to_create_a_heating_element/)

Una calculadora online⁸ (http://www.jacobs-online.biz/nichrome/NichromeCalc.html) permite familiarizarse con la relación entre la temperatura máxima deseada y la longitud, el diámetro, y la tensión y corriente de alimentación (Figura 5.3). Principalmente, el objetivo ha sido alcanzar una temperatura de al menos 220 °C y la suficiente longitud para dar 2 o 3 vueltas al horno de cristal. De todas formas, los valores de esta calculadora no se aplicaron directamente.

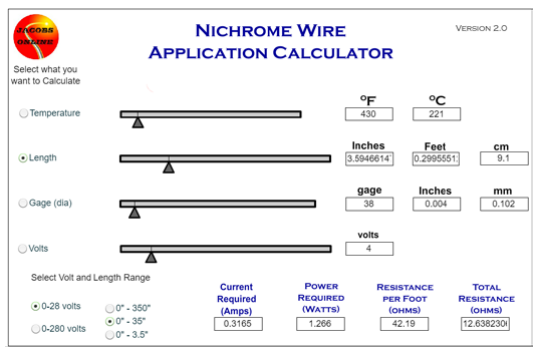
[picture p49: figure]

Por simplicidad y elegancia, se preferiría utilizar una sola fuente para el circuito de la bobina y el Arduino mediante su entrada Vin, pero se recomienda separar los circuitos para evitar el ruido.
Para la fuente externa, los módulos de alimentación como el MB102
están limitados a una salida de 700 mA⁹ (https://soloarduino.blogspot.com.es/2016/04/mb102-alimentacion-para-breadboards.html) y los cargadores USB suelen estar
limitados a 2.0 – 2.5 A. Por ello se acabó conectando un cargador de portátil antiguo a un convertidor “buck” cuya pantalla muestra las tensiones y corrientes de entrada y de salida (Figura 5.4). Al bajar la tensión de los 19 V del cargador a 13 V, el convertidor puede producir una corriente de salida mayor a los 3,31 A del cargador. Sus salidas están conectadas al transistor mediante una regleta de dos contactos, que puede soportar hasta 8 A¹⁰, (http://www.electronicaembajadores.com/Productos/Detalle/11/ctna2502/regleta-clema-pcb-paso-2-54mm-2-contactos) mayor que los 6,3 A máximos que circulan por el colector y emisor.

Fig. 5.3 Calculadora de aplicación⁸ (http://www.jacobs-online.biz/nichrome/NichromeCalc.html)

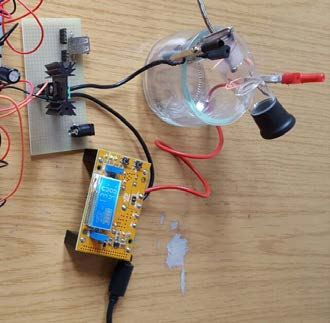
[picture p50: figure]

Fig. 5.4 Convertidor, transistor, y horno

Las corrientes del transistor y su resistencia de base se han determinado principalmente por prueba y error, basándose en parte en ciertas pautas básicas¹¹. (https://art511.wordpress.com/works-in-progress/how-to-use-a-transistor-as-a-switch/) Se conectó al horno directamente al convertidor buck y se iba aumentando la tensión y corriente de salida del convertidor hasta conseguir una temperatura máxima deseada de aproximadamente 300 °C. Dividiendo esta corriente del colector máxima entre β = 250 se halla la corriente de base

máxima y consecuentemente la resistencia de base necesaria. A continuación, introduciendo el transistor y asignándole un valor PWM de 255 se intentó llegar a esta máxima temperatura. En algunos intentos iniciales el transistor explotó ya que le faltaba un disipador de calor. El cálculo de la resistencia de base necesaria produjo un valor de aproximadamente 195 Ω. Sin embargo, al no dar buenos resultados con respecto a la corriente del colector, se optó por ir probando resistencias desde 5.1 KΩ hasta 220 Ω hasta dar con un valor aceptable. Con 330 Ω todavía funciona el circuito, pero al bajar a 220 Ω explotó el transistor. Con un transistor nuevo y volviendo a probar una resistencia de 330 Ω, el circuito volvió a funcionar por lo que se ha utilizado este valor en el circuito final. Ajustando la salida del convertidor un poco más permitió conseguir la misma temperatura máxima de alrededor de 300 °C.
Para el transistor, en lugar de un BJT se podría haber utilizado un MOSFET, cuya menor disipación de energía y su control por tensión habría sido útil¹². (https://www.luisllamas.es/arduino-transistor-mosfet/) Pero los transistores BJT son aptos para mandarles señales PWM y con comparar distintas hojas de especificaciones ³, (http://www.braude.ac.il/files/departments/electrical_electronic_engineering/labs/data_pages/p5.pdf)13 (https://art511.files.wordpress.com/2010/03/tip120.pdf) se puede determinar que el BDX33C puede soportar las tensiones y corrientes previstas.
La mayoría de las fuentes recomiendan un diodo flyback¹⁴ (https://www.luisllamas.es/salidas-mayor-potencia-arduino-transistor-bjt/) en paralelo con la bobina para disipar la corriente que permanece en el circuito de la bobina tras un corte de alimentación. Sin embargo, por limitaciones constructivas y de prioridades y, al ver que el circuito de momento no ha sufrido por faltarle el diodo, se ha ignorado ese componente. No obstante, se trata definitivamente de una adición futura al prototipo.
Referencias
1. http://hypertextbook.com/facts/2007/HarveyKwan.shtml
2. https://en.wikipedia.org/wiki/Nichrome
3. http://www.braude.ac.il/files/departments/electrical_electronic_engineering/labs/data_pages/p5.pdf
4. http://www.electronics-tutorials.ws/transistor/darlington-transistor.html
5. http://alexnld.com/product/5v-12v-zvs-induction-heating-power-supply-module-with-coil/
6. http://www.alanzucconi.com/2016/08/02/arduino-heater-1/
7. https://www.reddit.com/r/arduino/comments/3s08uf/most_efficient_way_to_create_a_heating_element/ (https://www.reddit.com/r/arduino/comments/3s08uf/most_efficient_way_to_create_a_heating_element/)
8. http://www.jacobs-online.biz/nichrome/NichromeCalc.html
9. https://soloarduino.blogspot.com.es/2016/04/mb102-alimentacion-para-breadboards.html
10. http://www.electronicaembajadores.com/Productos/Detalle/11/ctna2502/regleta-clema-pcb-paso-2-54mm-2-contactos (http://www.electronicaembajadores.com/Productos/Detalle/11/ctna2502/regleta-clema-pcb-paso-2-54mm-2-contactos)
11. https://art511.wordpress.com/works-in-progress/how-to-use-a-transistor-as-a-switch/
12. https://www.luisllamas.es/arduino-transistor-mosfet/
13. https://art511.files.wordpress.com/2010/03/tip120.pdf
14. https://www.luisllamas.es/salidas-mayor-potencia-arduino-transistor-bjt/

### 6 Control PID de Temperatura

Descripción
El sistema del horno, sensor, y Arduino conforman un bucle cerrado con control PID (Figura 6.0). El setpoint (SP) se fija con los pulsadores de temperatura y se compara con la salida del sensor de temperatura. Este error entra en el

# controlador PID GGcc(ss) = 3.2 + 0.095

ss + 4.5ss, que es una función del Arduino. Esta función entrega un valor PWM al horno, el cual está integrado con el sensor de temperatura para formar la planta GGpp(ss) = 0,0001403

# ss2+0,02139ss+0,0001157

y genera la variable del proceso (PV) detectada por el sensor.

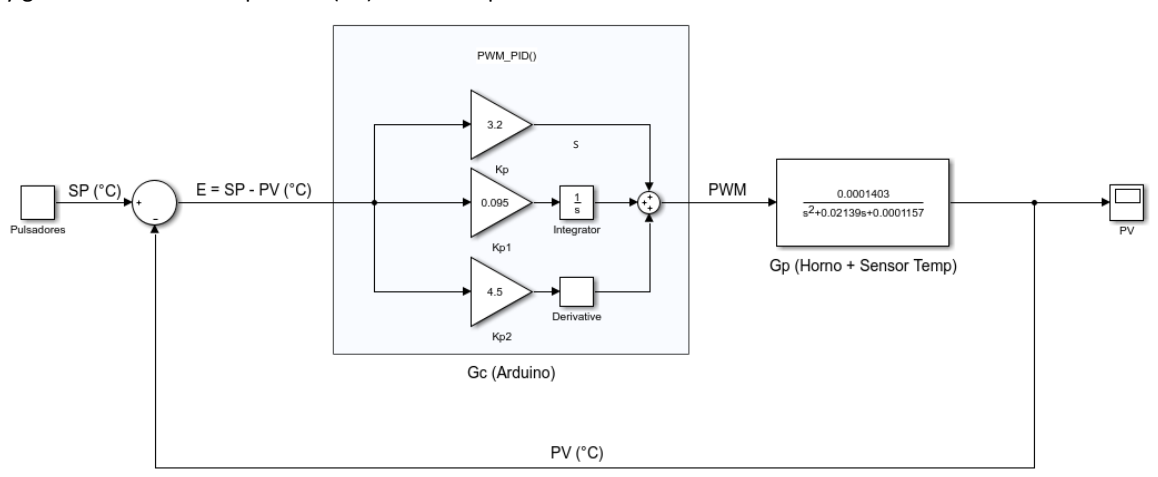
[picture p51: figure]

# Esta GGpp(ss) = 0,0001403 ss2+0,02139ss+0,0001157

tiene una ganancia estática KK = 1,2126188, una frecuencia natural ωω = 0,01075766, y un coeficiente de amortiguamiento de ξξ = 0,9942184. Se trata por lo tanto de una función subamortiguada, aunque casi críticamente amortiguada. Sus polos conjugados = −0,0106955 ± 0,00115123

prácticamente carecen de una parte imaginaria, lo cual es consistente con la naturaleza casi críticamente amortiguada de esta planta.

Fig. 6.0 Diagrama de bloques

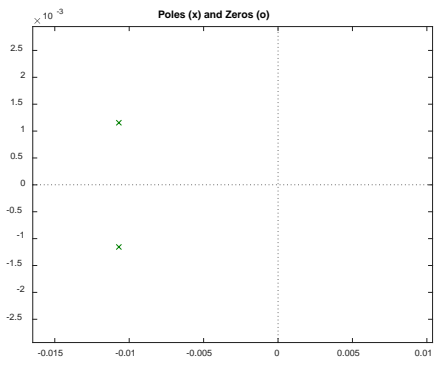
[picture p52: figure]
Poles (x) and Zeros (o)

Fig. 6.2 Polos del sistema

0 | 100 | 200 | 300 | 400 | 500 | 600 | 700 | 800 | 900 | 1000

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
From: PWM To: Temperatura

Step Response

Time (seconds)

Amplitude

Fig. 6.1 Respuesta al escalón del lazo abierto

En el siguiente apartado (Proceso) se detallan los ensayos empíricos que resultaron en una GGcc(ss) = 3.2 + 0.095
ss +
4.5ss, que se introduce en un bucle cerrado para obtener la función GG(ss) = 0.0006313ss2+0.000449ss+0.00001333
ss3+0.02202ss2+0.0005647ss+0.00001333.

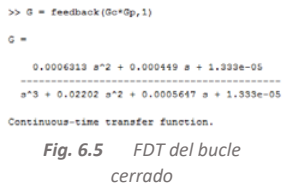
[picture p53: figure]
cerrado

El bucle cerrado muestra una reducción del tiempo de establecimiento de casi 67%, siendo éste la característica dinámica primaria a la hora de diseñar el controlador. La sobreoscilación generada no es importante, siendo menor que un 2%.

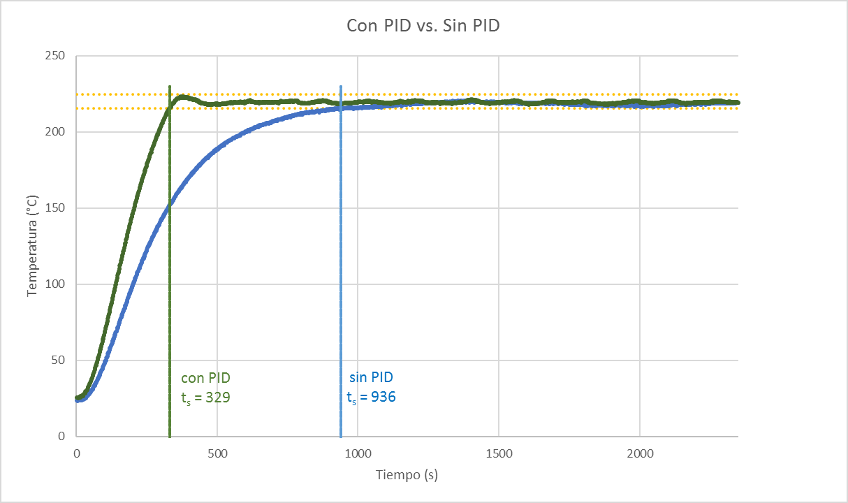
[picture p54: figure]

La función PWM_PID() corre en el loop() cada 5 segundos, ya que no es necesario vigilar la temperatura actual constantemente para este sistema relativamente lento. Esta función calcula y devuelve el Output (Figura 6.7), un valor PWM que se pasa como parámetro en la función calentarHorno() de la sección anterior.

Fig. 6.6 Lazo abierto sin control PID (azul) y lazo cerrado con control PID (verde)

Fig. 6.3 FDT del

Fig. 6.4 FDT de la planta | Fig. 6.5 FDT del bucle

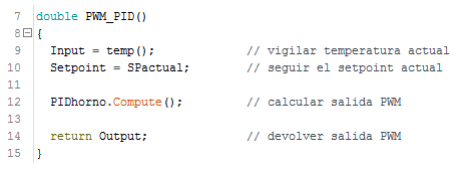
[picture p55: figure]

Fig. 6.7 Función PWM_PID()

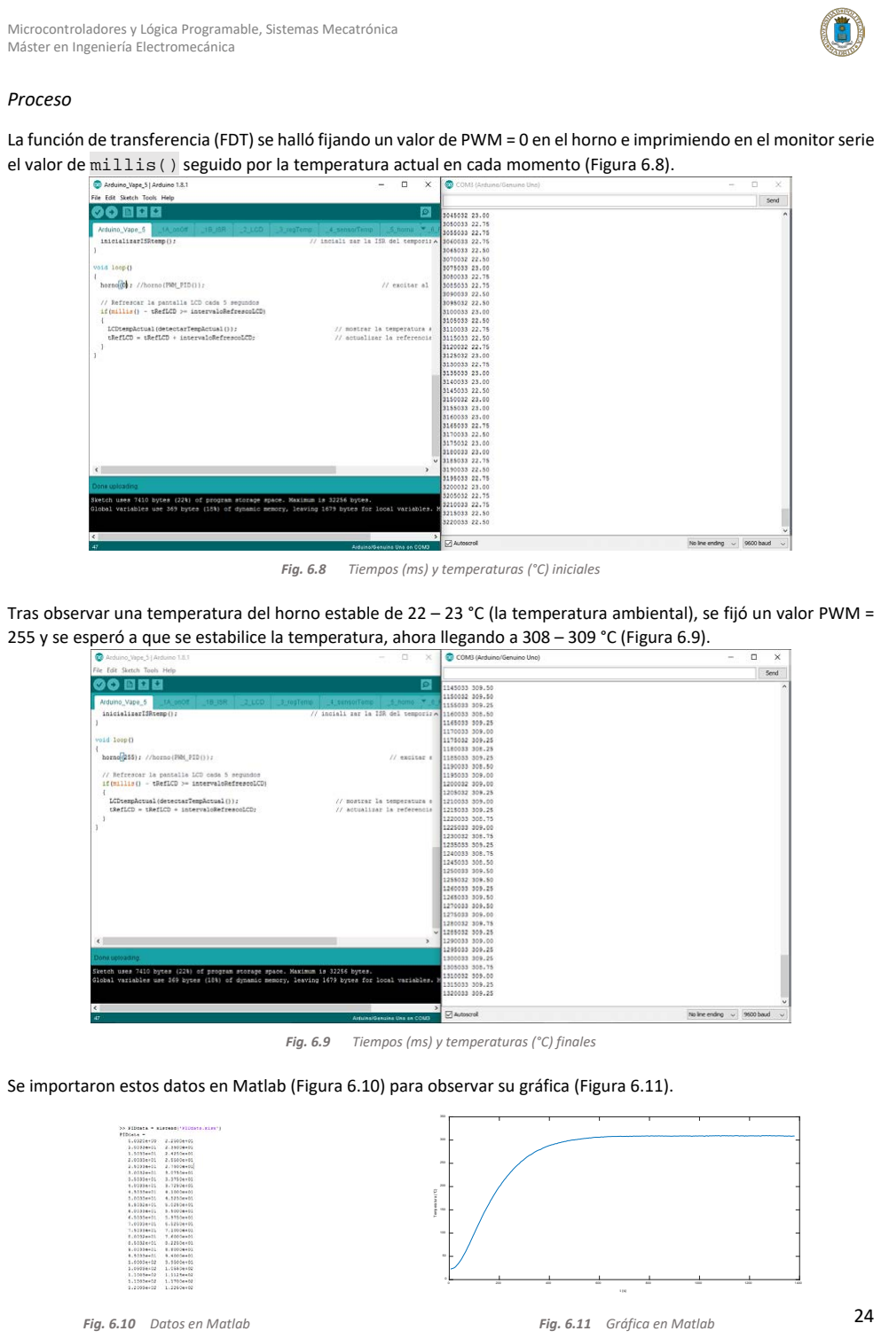
[picture p56: page 24]

Proceso
La función de transferencia (FDT)se halló fijando un valor de PWM = 0 en el horno e imprimiendo en el monitor serie el valor de millis() seguido por la temperatura actual en cada momento (Figura 6.8).

Tras observar una temperatura del horno estable de 22 – 23 °C (la temperatura ambiental), se fijó un valor PWM = 255 y se esperó a que se estabilice la temperatura, ahora llegando a 308 – 309 °C (Figura 6.9).

Se importaron estos datos en Matlab (Figura 6.10) para observar su gráfica (Figura 6.11).

Fig. 6.8 Tiempos (ms) y temperaturas (°C) iniciales

Fig. 6.9 Tiempos (ms) y temperaturas (°C) finales

Fig. 6.10 Datos en Matlab

0 | 200 | 400 | 600 | 800 | 1000 | 1200 | 1400
t (s)

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
Temperatura (°C)

Fig. 6.11 Gráfica en Matlab

Se estimó una FDT mediante la aplicación de Matlab de identificación de sistemas (Figura 6.12). Se exigió una FDT con 2 polos porque los sistemas térmicos suelen ser de segundo orden¹, (https://www.ncnr.nist.gov/staff/dimeo/riddle/temp_control_presentation.pdf) 2
. (https://ocw.mit.edu/courses/mechanical-engineering/2-003-modeling-dynamics-and-control-i-spring-2005/readings/notesinstalment2.pdf)

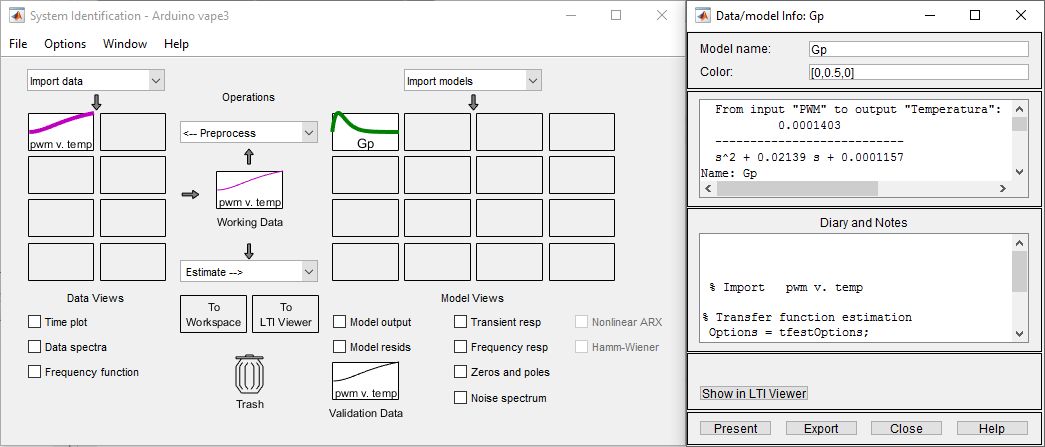
[picture p57: figure]

Este método proporciona una FDT que se compara con su forma genérica para hallar sus parámetros:

# GG (ss) = 0,0001403

# ss2 + 0,02139ss + 0,0001157 = KK ωωnn

2

# ss2 + 2ξξωωnnss + ωn

2
De la igualdad se halla la frecuencia natural ωω , la ganancia estática KK , y el coeficiente de amortiguamiento ξξ:

El valor de KK = 1,2126188 se confirma con su respuesta al escalón (Figura 6.18) mientras que los resultados explícitos de la función damp() (Figura 6.13) confirman cierto error de redondeo de la GGpp(ss). Para no arrastrar este error al cálculo de las características dinámicas, se corrigió ωω y ξξ.

Fig. 6.12 Identificación del sistema Matlab

# KK ωω2 = 0,0001403 ⇒ KK = 0,0001403

ωω2 = 0,0001403
0,0001157 ⇒ KK = 1,2126188

# 2ξξωω = 0,02139 ⇒ ξξ = 0,02139

2ωω = 0,02139
2(0,0107564) ⇒ ξξ = 0,99429

# ωω2 = 0,0001157 ⇒ ωω = 0,0107564 →

→

ωω = 0,01075766
ξξ = 0,9942184

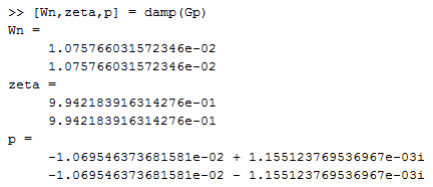
[picture p58: figure]

Fig. 6.13 Función damp() en Matlab

El coeficiente de amortiguamiento ξξ = 0,9942184 ≅ 1 indica que es un sistema prácticamente críticamente

amortiguado. Por si acaso, se probó a exigir una FDT críticamente amortiguada, la cual se aproxima a los datos peor (Best Fit = 99.36%) que la FDT subamortiguada (Best Fit = 99.45%) (Figura 6.14).

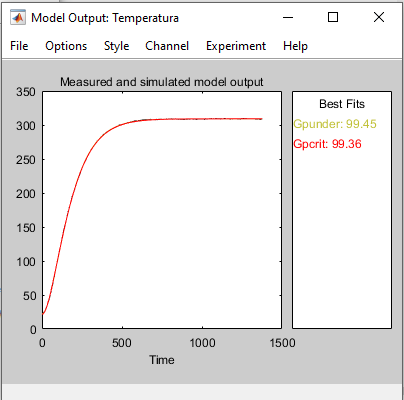
[picture p59: figure]

Sus polos conjugados, efectivamente, tienen una parte real negativa (σσ = −0,01069 < 0) y una parte imaginaria muy pequeña (ωω = 0,00115 ≈ 0) los cuales confirman, respectivamente, que es un sistema estable y casi

críticamente amortiguado (Figura 6.15):

Aún con la corrección anterior de ωω y ξξ, las características dinámicas salen con mucho error (Figura 6.16) y se

observa que los resultados de stepinfo() (Figura 6.17) concuerdan más con la respuesta al escalón (Figura 6.18).

# = σσ ± ωω = −ξξωω ± 1 − ξξ2 ⇒

⇒ = −0,9942184 ∙ 0.01075766 ± 0.010757661 − 0,99421842 ⇒ ⇒ = −0,0106955 ± 0,00115123

Fig. 6.15 Polos del sistema

-0.015 | -0.01 | -0.005 | 0 | 0.005 | 0.01

-2.5

-2

-1.5

-1

-0.5

0

0.5

1

1.5

2

2.5

10 -3 | Poles (x) and Zeros (o)

Fig. 6.14 Comparación de sistemas en Matlab

0 | 100 | 200 | 300 | 400 | 500 | 600 | 700 | 800 | 900 | 1000

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
From: PWM To: Temperatura

Step Response

Time (seconds)

Amplitude

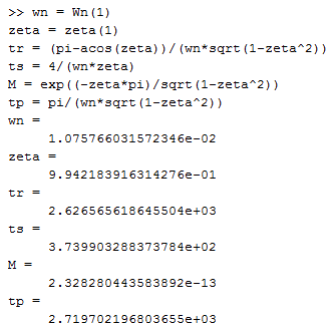
[picture p60: figure]
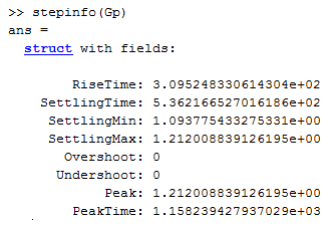
[picture p61: figure]

Fig. 6.16 Cálculos de las | Fig. 6.18 Respuesta al escalón en lazo abierto
variables dinámicas

Fig. 6.17 Generación directa de las variables dinámicas

Inicialmente se intentó hallar los parámetros del controlador mediante la asignación de polos:
Al añadir un polo en ss = −ααωω , el denominador adquiere la forma (ss + ααωω ) ∙ (ss2 + 2ξξωω ss + ωω2) = ss3 +
2ξξωω (1 + αα)ss2 + ωω2(1 + 2ααξξ)ss + ααωω3, que al comparar con el denominador anterior produce unos parámetros en función de ωωnn y ξξ:
ss3 + (0,02139 + 0,0001403KK )ss2 + 0,0001157 + 0,0001403KKppss + 0,0001403KKii = ss3 + 2ξξωω (1 + α)ss2 + ωω2(1 + 2ααξξ)s + ααωω3 ⇒

# 0,02139 + 0,0001403KK = 2ξξωω (1 + α) ⇒ K = 2ξξωω (1 + α) − 0,02139

0,0001403

# 0,0001157 + 0,0001403KKpp = ωω2(1 + 2ααξξ) ⇒ Kp = ωω2(1 + 2ααξξ) − 0,0001157

0,0001403

# 0,0001403KKii = ααωω3 ⇒ Ki = ααωω3

0,0001403
Se busca una reducción de en el tiempo de establecimiento ttss = 536 ss y de subida tt = 310 ss a un 25% de su valor,

# por lo que se busca una ttss = 94,15 ss y tt = 59,76 ss:

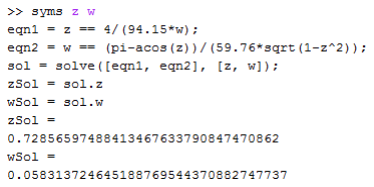
[picture p62: figure]

Con una ωω = 0,05314 y ξξ = 0,72857, y eligiendo una αα = 10, se hallan los parámetros del controlador:

# KKpp = (0,053142)1 + 2(10)(0,72857) − 0,0001261

4,378 ∙ 10−5 = 1001,49

# KKii = (10)(0,053143)

4,378 ∙ 10−5 = 34,28
KK = 2(0,72857)(0,05314)(1 + 10) − 0,01918
4,378 ∙ 10−5 = 19017,28
Estos valores tan altos no producían resultados satisfactorios. La KKpp resultaba sobreoscilaciones muy exageradas y la KK producía valores de PWM erráticos y muy altos, aún cuando se había sobrepasado el SP, y no permitía bajar la temperatura. Además, la KK causaba errores al leer la variable Input (la PV) de la función PID.

# Gp(s) = 0,0001403 ss2 + 0,02139ss + 0,0001157 Gc(s) = Kp +

KKii

# s + K s = Kps + Ki + K ss2

ss

Fig. 6.19 Determinación de los nuevos parámetros ξξ y ωω

# ttss = 4

# ωω ξξ ⇒ 94,15 = 4

# ωω ξξ ⇒ ξξ = 4

94,15ωω

# tt = ππ − cos−1(ξξ)

# ωω 1 − ξξ2 ⇒ 59,76 = ππ − cos−1(ξξ)

# ωω 1 − ξξ2 ⇒ ωω = ππ − cos−1(ξξ)

59,761 − ξξ2

# G(s) = Gc(s) ∙ Gp(s) 1 + Gc(s) ∙ Gp(s) =

# Kps + Ki + K ss2

ss ∙ 0,0001403

# ss2 + 0,02139ss + 0,0001157

1 +

# Kps + Ki + K ss2

ss ∙ 0,0001403

# ss2 + 0,02139ss + 0,0001157

=
= (0,0001403) ∙ Kps + Ki + K ss2 ss3 + (0,02139 + 0,0001403KK )ss2 + 0,0001157 + 0,0001403KKppss + 0,0001403KKii

Por ello se recurrió a la aplicación de PID de Matlab, con la que se buscaba un tiempo de establecimiento rápido, pero sin grandes sobreoscilaciones para reducir el desperdicio de energía (Figura 6.20).

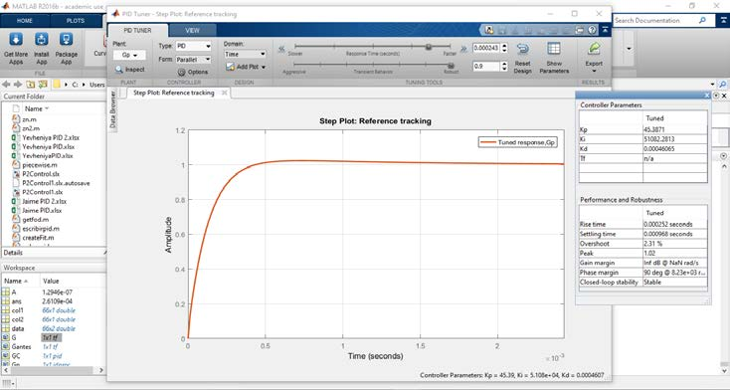
[picture p63: figure]

El controlador obtiene la forma GGcc(ss) = KKpp + KK

# ss + KK ss = 45.4 + 51082

# ss + 0.00461ss y junto con la GGpp(ss) se halla el

# lazo cerrado GG(ss) = GGcc(ss)GGpp(ss) 1+GGcc(ss)GGpp(ss) = 17134 (ss+9,739∙104)(ss+1139) (ss+2,136∙105)(ss+7395)(ss+1203)

:

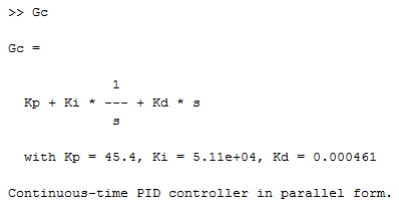
[picture p64: figure]

Las nuevas características dinámicas implican una mejora:

Fig. 6.20 PID Tuner de Matlab

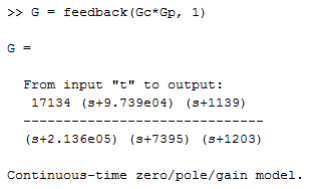
[picture p65: figure]

Fig. 6.21 Controlador en Matlab | Fig. 6.22 Lazo cerrado en Matlab

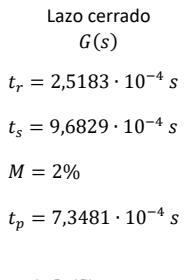
[picture p66: figure]
tt = 2,5183 ∙ 10−4 ss ttss = 9,6829 ∙ 10−4 ss MM = 2% ttpp = 7,3481 ∙ 10−4 ss; Lazo cerrado
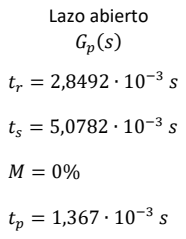
[picture p67: figure]
tt = 2,8492 ∙ 10−3 ss ttss = 5,0782 ∙ 10−3 ss MM = 0% ttpp = 1,367 ∙ 10−3 ss; Lazo abierto; GGpp(ss)

Step Response

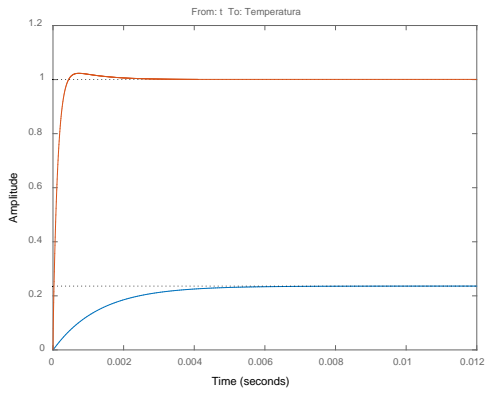
[picture p68: figure]
From: t To: Temperatura; Time (seconds); Amplitude
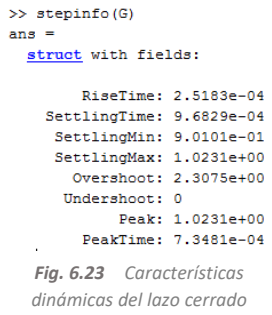
[picture p69: figure]
Fig. 6.23 Características dinámicas del lazo cerrado

Fig. 6.24 Lazo abierto (azul) y cerrado (naranja)

Desafortunadamente, estos valores producían efectos similarmente erráticos o exagerados, posiblemente porque los cálculos teóricos no representan bien al sistema real, cuya inercia térmica parecía muy difícil de controlar. Por ello se acabó dependiendo del método de prueba y error. Para ellos, unas pautas básicas para sistemas térmicos³ (http://forum.seemecnc.com/viewtopic.php?t=11440) recomiendan empezar por un aumento de KKpp. Efectivamente, aumentaba las oscilaciones, pero reducía el error (Figura 6.25). Fijando un valor de KKpp, en principio satisfactorio, se aumentó gradualmente la KKii, la cual reducía el

error en el régimen permanente y aumentaba la sobreoscilación (Figura 6.26). Fijado los dos anteriores parámetros y aumentando la KK , se reduce la sobreoscilación considerablemente (Figura 6.27).

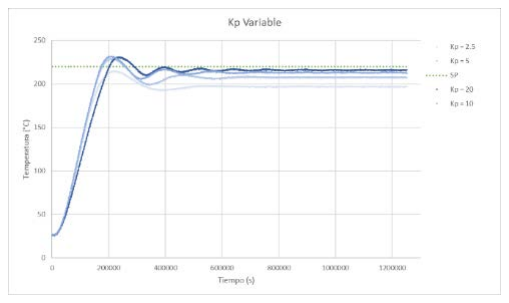
[picture p70: figure]
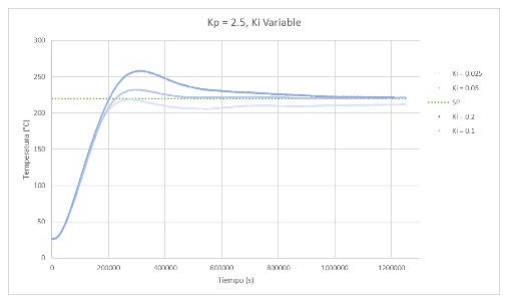
[picture p71: figure]
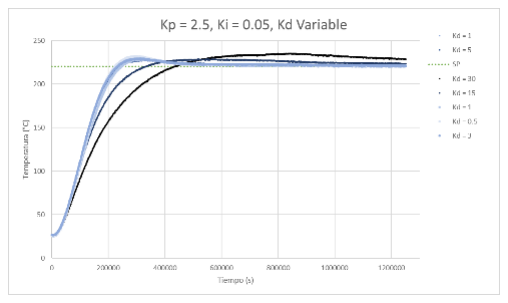
[picture p72: figure]

Estos perfiles permitían formar una idea de los efectos de cada parámetro sobre el sistema. De las distintas combinaciones (Figura 6.28), se optó por Kp = 3.2, Ki = 0.095, y Kd = 4.5.

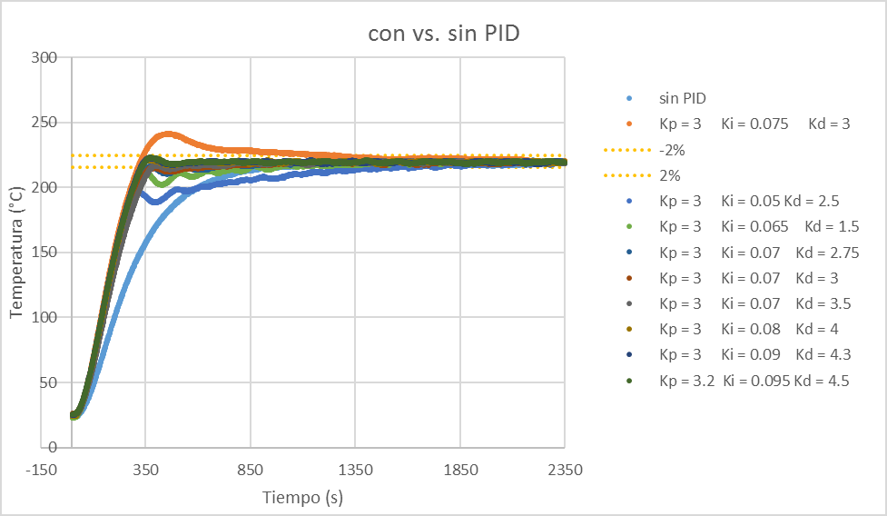
[picture p73: figure]

Referencias
1. https://www.ncnr.nist.gov/staff/dimeo/riddle/temp_control_presentation.pdf
2. https://ocw.mit.edu/courses/mechanical-engineering/2-003-modeling-dynamics-and-control-i-spring-2005/readings/notesinstalment2.pdf (https://ocw.mit.edu/courses/mechanical-engineering/2-003-modeling-dynamics-and-control-i-spring-2005/readings/notesinstalment2.pdf)
3. http://forum.seemecnc.com/viewtopic.php?t=11440

Fig. 6.28 Combinaciones de parámetros PID

Fig. 6.25 Aumento de Kp | Fig. 6.26 Aumento de Ki | Fig. 6.27 Aumento de Kd

### 7 Comunicaciones

Descripción
El vaporizador, basado en un Arduino Uno, se comunica por el bus I²

C con un Arduino Uno Wifi. El Uno envía datos de temperatura al Uno Wifi, el cual publica estos datos por MQTT a una Raspberry Pi para su monitoreo y almacenaje. A su vez, el Uno Wifi se subscribe para recibir unos comandos de encendido/apagado y de regulación de la temperatura para enviarlos al Uno (Figura 7.0).

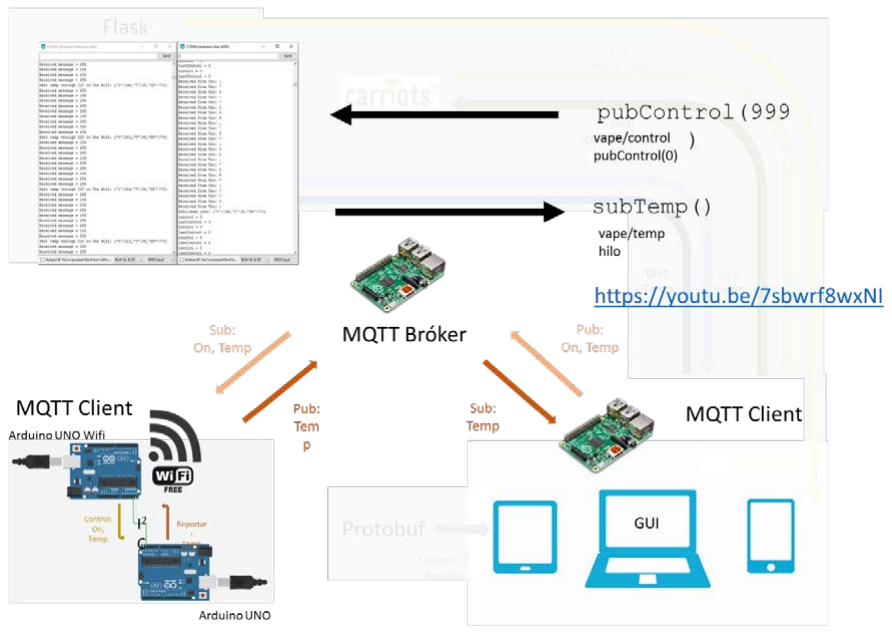
[picture p74: figure]

El Uno calcula el tiempo en segundos de la medida de temperatura que va a mandar, asegurándose de comparar con el mismo tiempo de referencia. A continuación, con la librería ArduinoJson.h¹ (https://bblanchon.github.io/ArduinoJson/doc/encoding/) se reservan 256 bytes para

### este array de caracteres. Se crea el objeto json = {"t": tiempo, "T": temperatura, "SP":

SPactual} y se rellena el jsonArray con estos contenidos (Figura 7.1).

Fig. 7.0 Comunicación por I² C y MQTT

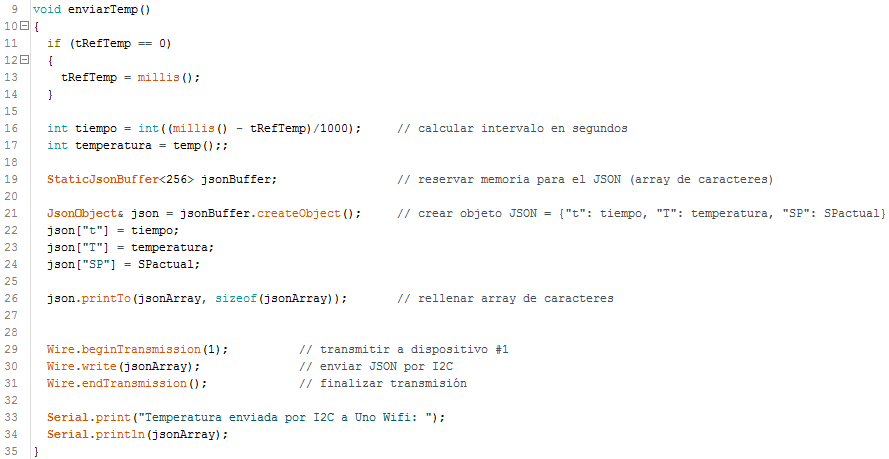
[picture p75: figure]

Para enviar el jsonArray por I²

C se conectan las patillas A4 (SDA: los datos) y A5 (SCL: el reloj) entre los Arduinos, así como la tierra común²
. (http://www.instructables.com/id/I2C-between-Arduinos/) La Figura 7.2 muestra los bits de la línea SDA, que empiezan a leerse con un flanco negativo de mientras SCL = 1. Dada esta condición de Start, los primeros 7 bits esla dirección del esclavo, seguido por la acción escribir (R/W = 0) o leer (R/W = 1) del esclavo, y terminando el primer byte con un bit de Acknowledge, usado por el esclavo para indicar la recepción exitosa de la secuencia anterior. Los siguientes 8 bits suelen son para los registros internos del esclavo, por ejemplo, cuando se quiere leer el eje X de un acelerómetro de 3 ejes, terminando también con un bit ACK. Los siguientes grupos de 8 bits constituyen los datos del mensaje, que se envía hasta que se recibe la señal de terminación Stop, que ocurre con un flanco positivo de SDA = 1 mientras SCL = 1³
. (http://howtomechatronics.com/tutorials/arduino/how-i2c-communication-works-and-how-to-use-it-with-arduino/)

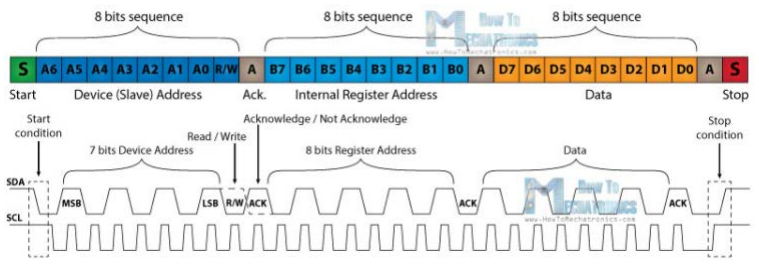
[picture p76: figure]

Con la librería Wire.h se envía el array del json mediante la comunicación I²

C⁴

, (https://www.arduino.cc/en/Tutorial/MasterWriter) habiéndose asignado en el setup() como maestro ya que su función Wire.begin() carece de parámetros, es decir, de una dirección. En la función enviarTemp() se inicia la transmisión, se envía el array, y se cierra la transición (Figura 7.1).

Fig. 7.1 Enviar temperatura por I² C

Fig. 7.2 Líneas SDA y SCL del bus I² C ³ (http://howtomechatronics.com/tutorials/arduino/how-i2c-communication-works-and-how-to-use-it-with-arduino/)

En el otro extremo, el Arduino Uno Wifi se establece en el setup() como un esclavo en la dirección 1 del bus I²

C y
prepara las funciones a ejecutar en caso de recepción o petición de datos por este bus (Figura 7.3). Al recibir datos, se llama a la función receiveEvent(), la cual recibe el array por I²

C de char en char y los va almacenando en json[] (Figura 7.4). Va avanzando por el array ya que se mantiene en el bucle de Wire.available() mientras siga detectando un flujo de datos por el bus I²
C, aumentando el índice en cada vuelta. Con la marca booleana publicado, el Arduino Uno Wifi evita la doble publicación de un mismo json.

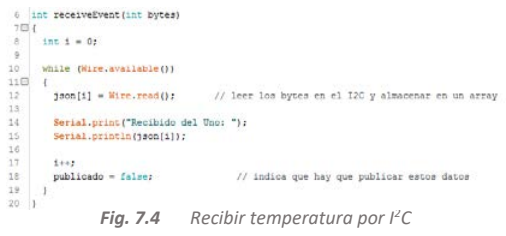
[picture p77: figure]
Fig. 7.4 Recibir temperatura por I² C
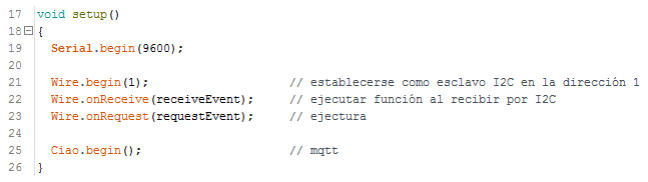
[picture p78: figure]

La Figura 7.5 muestra como el Arduino Uno (COM5) envía el array del json para que el Arduino Uno Wifi (COM4) lo recibe de char en char para formar el json a publicar.

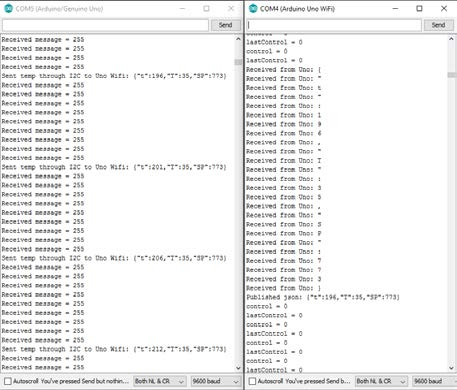
[picture p79: figure]

En el loop() se llama a la función mqttPub() sólo si la marca publicado = false indica que este json todavía no se ha publicado (Figura 7.6). Está función de la librería Ciao⁵ (http://www.arduino.org/learning/reference/ciao-library) utiliza el connector “mqtt” para publicar el array al topic “vape/temp” e indicar que ha publicado algo con publicado = true (Figura 7.7).

Fig. 7.5 Traspaso de JSON de Arduino Uno a Uno Wifi

Fig. 7.3 Función setup() del Arduino Uno Wifi

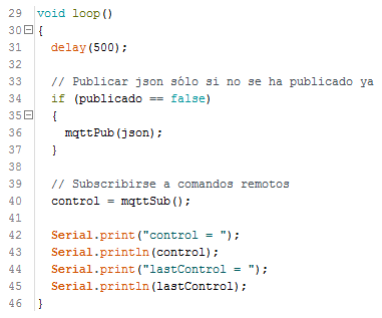
[picture p80: figure]

Fig. 7.6 Recibir temperatura por I² C

Fig. 7.7 Publicar temperatura por MQTT

A la misma vez, la función | mqttSub() | está en el | loop() | constantemente subscribiéndose a el topic
"vape/control" a la espera de comandos remotos (Figura 7.6). Si se recibe un dato, se guarda en un char y posteriormente se convierte a un int (Figura 7.8).

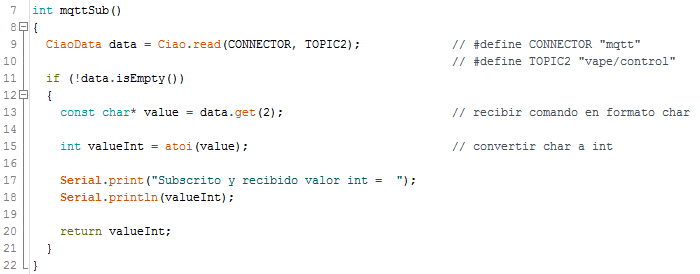
[picture p81: figure]

Este valor entero se devuelve para guardarlo en la variable control (Figura 7.6). El Arduino Uno Wifi envía esta variable por I²

C como esclavo⁶ (https://www.arduino.cc/en/Tutorial/MasterReader) mediante la función requestEvent() (Figura 7.9). Esta función comprueba que el mensaje actual y último mensaje enviado son distintos para evitar duplicados y además comprueba que el último valor recibido es un cero. Se crea un array de 2 bytes llamado myArray[] y en el primero se introduce el segundo byte de control mediante un traslado de 8 bits (operador Bitshift⁷

) (https://www.arduino.cc/en/Reference/Bitshift) y una operación AND bit a bit y el segundo byte myArray[] se llena con el primer byte de

### control⁸

. (https://thewanderingengineer.com/2015/05/06/sending-16-bit-and-32-bit-numbers-with-arduino-i2c/)

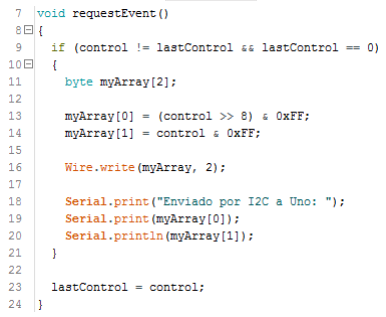
[picture p82: figure]
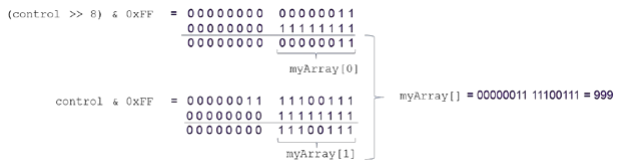
[picture p83: figure]

La Figura 7.10 muestra un ejemplo de esta manipulación de bits para el caso en que control = 9 99, es decir, los bytes 00000011 11100111. La función requestEvent() envía los 2 bytes del array por el bus I
2

C y almacena el
valor del último mensaje (Figura 7.9).

Por último, la función recibirControl() permite al Arduino Uno recibir el comando proveniente del Arduino Uno Wifi por el bus I
2

C (Figura 7.11). Esto consiste en exigir 2 bytes al maestro del esclavo en la dirección 1 con Wire.requestFrom(1, 2) y esperar a que lleguen los dos, los cuales se van guardando cada uno en el byte a o b. La variable message es un entero que almacena en su segundo byte el byte a y traslada al byte b 8 bits a su izquierda para almacenarlo en su primer byte con una operación OR bit a bit⁸
. (https://thewanderingengineer.com/2015/05/06/sending-16-bit-and-32-bit-numbers-with-arduino-i2c/)

Fig. 7.8 Subscribir por MQTT

Fig. 7.10 Ejemplo de operaciones con bits para enviar control Fig. 7.9 Enviar control por I² C

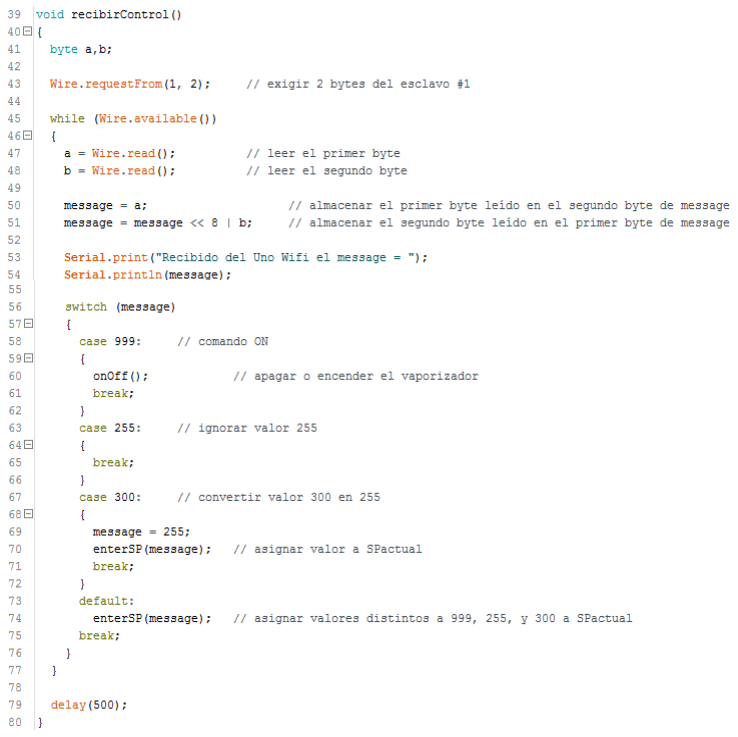
[picture p84: figure]
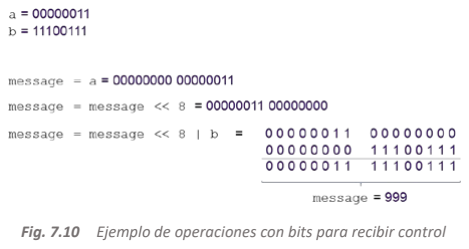
[picture p85: figure]

Siguiendo el ejemplo anterior donde myArray[] = 00000011 11100111, la Figura 7.10 muestra su almacenaje en la variable message. En el caso de que esta variable valga 999, el sistema se apagará o encenderá con la función onOff(). Un valor de 255 se descarta, por tratarse de un valor que por defecto aparece cuando el maestro no recibe nada⁹
. (http://forum.arduino.cc/index.php?topic=139286.0) En su lugar, se utiliza el valor de 300, que nunca puede asignarse como SP por ser excesivamente alto, para representar al valor de 255. De esta forma, los valores distintos al 999 se introducen en la función enterSP(), que asignará el valor a la SPactual (Sección 3).

Proceso
La idea original era conectar un módulo ESP8266 (en lugar del Arduino Uno Wifi) al Arduino Uno, pero no fue posible establecer la comunicación pese a distintos intentos de cableado y de actualización del firmware ESP. Para este proyecto el Arduino Uno Wifi sirve como una representación simbólica del módulo ESP8266. Es más, el Uno Wifi lleva integrado este mismo módulo.
En el loop(), se incluye un delay() de 500 milisegundos ya que con un millis() la comunicación por MQTT no parecía funcionar. Se sospecha que el procesador debe dormirse, aunque sea medio segundo para reducir el ruido o la confusión entre las funciones de publicar y subscribir.

Fig. 7.11 Recibir control por I² C

Fig. 7.10 Ejemplo de operaciones con bits para recibir control

El Arduino Uno parecía recibir mensajes I²

C por duplicado por lo que hay que vigilar el último valor recibido. Además, la comunicación por MQTT se beneficia del envío de una señal de 0 entre mensajes.
Por último, el Arduino Uno recibe un valor de 255 constantemente siempre que no reciba un mensaje I²
C del
Arduino Uno Wifi. Por ello se debe burlar este efecto asignándole ningún comando al mensaje de 255 y en su lugar utilizando un mensaje de 300 como un comando de 255.

Referencias

1. https://bblanchon.github.io/ArduinoJson/doc/encoding/
2. http://www.instructables.com/id/I2C-between-Arduinos/
3. http://howtomechatronics.com/tutorials/arduino/how-i2c-communication-works-and-how-to-use-it-with-arduino/ (http://howtomechatronics.com/tutorials/arduino/how-i2c-communication-works-and-how-to-use-it-with-arduino/)
4. https://www.arduino.cc/en/Tutorial/MasterWriter
5. http://www.arduino.org/learning/reference/ciao-write
6. https://www.arduino.cc/en/Tutorial/MasterReader
7. https://www.arduino.cc/en/Reference/Bitshift
8. https://thewanderingengineer.com/2015/05/06/sending-16-bit-and-32-bit-numbers-with-arduino-i2c/
9. http://forum.arduino.cc/index.php?topic=139286.0
